tiagojanz/winddragons_rover/hardware/dual_esp_carrier/Dual_ESP_Carrier.png

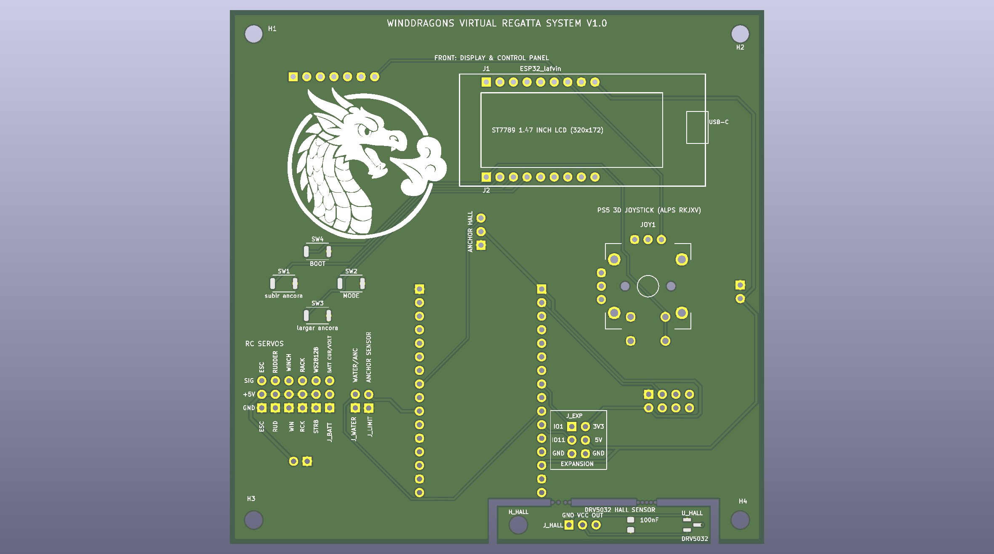
hardware/dual_esp_carrier/Dual_ESP_Carrier.png
