tiagojanz/winddragons_rover/hardware/dual_esp_carrier/Dual_ESP_Carrier_BACK.png

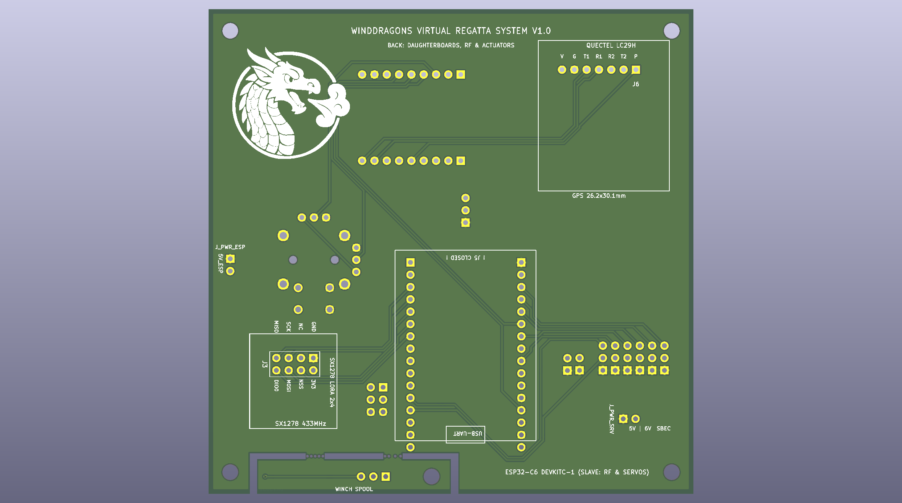
hardware/dual_esp_carrier/Dual_ESP_Carrier_BACK.png
