tiagojanz/winddragons_rover/README.md

# WindDragons - Sistema de Telemetria e Controlo Náutico (Base & Rover)

Projeto de automação e telemetria para boias robóticas náuticas autónomas (**Rovers**) e estação de controlo com ecrã (**Base Station**), baseado na **arquitetura universal Dual ESP32-C6** (Master Lafvin LCD 1.47" + Coprocessador DevKitC-1).

---

## 🛰️ Arquitetura do Sistema (Dual ESP32-C6 em Ambos os Nós)

```
[ WindDragons Portal (Cloud) ]
        ▲
        │ HTTPS REST API (JSON)
        ▼
┌────────────────────────────────────────────────────────┐
│ BASE STATION (Dual ESP32-C6)                           │
│  - Master Lafvin: LCD 1.47" IPS, MicroSD, Web/WiFi,   │
│                   Joystick PS5 e Coordenador OTA Dual │
│         ▲                                              │
│         │ UART Inter-ESP (921600 baud)                │
│         ▼                                              │
│  - Coprocessador C6: Rádio LoRa SX1278 (433MHz)       │
└──────────────────────────┬─────────────────────────────┘
                           │
                           │ LoRa 433 MHz (Ra-02 / SX1278)
                           ▼
┌────────────────────────────────────────────────────────┐
│ ROVER (Boia Náutica - Dual ESP32-C6)                   │
│  - Master Lafvin: LCD 1.47" IPS, MicroSD, Web/WiFi,   │
│                   Joystick local e Coordenador OTA    │
│         ▲                                              │
│         │ UART Inter-ESP (921600 baud)                │
│         ▼                                              │
│  - Coprocessador C6: LoRa 433MHz, GPS LC29H, PWM     │
│    (Motor, Leme, Guincho, Trinco) e Sensores          │
└────────────────────────────────────────────────────────┘
```

---

## 🔌 Esquema de Barramentos e Conexões

O módulo **LoRa Ra-02 (SX1278 a 433MHz)** é ligado exclusivamente ao **Coprocessador ESP32-C6** (evitando conflito com o barramento SPI partilhado entre o LCD e o MicroSD do Lafvin):

### Módulo LoRa SX1278 (433MHz) — Coprocessador ESP32-C6 DevKitC
| Pino Ra-02 | Pino ESP32-C6 | Notas |
| :--- | :--- | :--- |
| **VCC** | `3.3V` | Barramento independente 3.3V_C6 |
| **GND** | `GND` | Terra comum de referência |
| **SCK** | `GPIO 5` | Hardware SPI SCLK |
| **MOSI**| `GPIO 7` | Hardware SPI MOSI |
| **MISO**| `GPIO 4` | Hardware SPI MISO |
| **NSS / CS** | `GPIO 6` | Hardware SPI CS do LoRa |
| **DIO0**| `GPIO 0` | Interrupção de receção de pacotes |

---

### Slot MicroSD (TF Card Onboard) — Em ambas as placas
O slot MicroSD está integrado diretamente na placa ESP32-C6-LCD-1.47 e partilha o barramento SPI com o ecrã ST7789:
| Função SD | Pino ESP32-C6 | Notas |
| :--- | :--- | :--- |
| **CS** | `IO4` | Chip Select do Cartão SD (Ativo LOW) |
| **MOSI** | `IO6` | Partilhado com LCD MOSI |
| **SCLK** | `IO7` | Partilhado com LCD SCLK |
| **MISO** | `IO5` | Linha de leitura MISO |

**Ficheiros suportados na raiz do cartão:**
- `/config.txt` — Ficheiro de configurações lido automaticamente no boot.
- `/waypoints.txt` — Ficheiro de coordenadas de navegação (lido no Rover).
- `/telemetry.csv` — Registo automático de telemetria (GPS, velocidade, rumo, bateria e estado do motor).

---

### Build 1: ROVER (A Boia)
| Componente | Pino do Módulo / Atuador | Pino ESP32-C6 | Função |
| :--- | :--- | :--- | :--- |
| **Motor (ESC)** | Sinal PWM | `IO0` | 50Hz PWM (1000µs a 2000µs, centro 1500µs) |
| **Servo do Leme** | Sinal PWM | `IO1` | 50Hz PWM (Ângulo de direção) |
| **Guincho Âncora** | Sinal PWM | `IO23` | Servo de rotação contínua (1500µs parado, <1500 desce, >1500 sobe) |
| **GPS Quectel LC29H** | TX do GPS | `IO19` | RX UART1 (115200 bps) |
| | RX do GPS | `IO18` | TX UART1 |
| | VCC / GND | `3.3V / GND` | Alimentação |
| **LED RGB Onboard** | Integrado | `IO8` | Estado: Verde (GPS OK), Azul (LoRa), Vermelho (Failsafe) |

---

### Build 2: BASE (Comando Remoto com Ecrã)
| Componente | Pino do Módulo | Pino ESP32-C6 | Função |
| :--- | :--- | :--- | :--- |
| **Joystick (4 vias)** | VCC | `3.3V` | Alimentação do joystick |
| | GND | `GND` | Terra |
| | VRx (Avanço/Recuo) | `IO0` | Entrada Analógica ADC1_CH0 (Aceleração) |
| | VRy (Direção) | `IO1` | Entrada Analógica ADC1_CH1 (Leme) |
| **Botões de Âncora** | Subir Âncora | `IO18` | Entrada Digital (Pull-up interno) |
| | Descer Âncora | `IO19` | Entrada Digital (Pull-up interno) |
| **Botão BOOT** | Onboard | `IO9` | Cicla páginas de ecrã (Comando -> Frota -> Rede) |
| **Ecrã LCD 1.47"** | Integrado ST7789 | `IO14, 15, 21, 22` | Dashboard multi-ecrã Landscape 320x172 (Comando, Frota de Rovers e Rede WiFi) |

---

## 🌐 Conectividade WiFi, Modo AP & Servidor Web

A Base Station inclui gestão inteligente de ligações WiFi e um Servidor Web HTTP responsivo:

### 1. Arranque Inteligente e Fallback para Modo AP:
- **No arranque**: a Base tenta ligar-se à rede marcada como **Padrão (Default)** ou às redes secundárias guardadas na memória NVS (timeout de 8s).
- **Se não houver ligação**: entra automaticamente em **Modo Ponto de Acesso (AP)**:
  - **SSID do AP**: `WindDragons-Base`
  - **Password**: `12345678`
  - **Endereço IP**: `http://192.168.4.1`
- **Ecrã LCD**: ao arrancar (e no menu através de `7. INFO REDE / IP`):
  - Se ligado a WiFi: apresenta o **endereço IP** atribuído (`http://192.168.x.x`), SSID e sinal RSSI.
  - Se em modo AP: apresenta o **SSID da Base**, a password e o endereço `http://192.168.4.1`.

### 2. Páginas do Servidor HTTP:
- **Em Modo AP**:
  - `/wifi`: Interface para procurar redes próximas (Scan WiFi), adicionar redes e marcar a rede de casa/porto como **Default**.
- **Em Modo WiFi (Cliente)**:
  - `/wifi`: Gestão de múltiplas redes guardadas, alteração da rede default, remoção e scanner de sinal.
  - `/gps`: Telemetria e coordenadas GPS do Rover ativo, rumo da proa, velocidade em nós e links diretos para Google Maps e OpenStreetMap.
  - `/battery`: Monitorização da bateria LiPo 4S (tensão do pack, média por célula, percentagem colorida e estado de saúde).
  - `/control`: Comando remoto da boia via rádio LoRa (acelerador do motor ESC com presets, leme, âncora, cremalheira, hold station e botão de paragem de emergência).

---

## 🚀 Como Compilar e Enviar o Firmware

Com o **PlatformIO** instalado:

### 1. Compilar e Enviar para o Rover:
O Rover possui dois módulos ESP32-C6:
- **Rover C6 (Slave):** Controla Rádio LoRa, GPS LC29H, ESC do Motor, Servos e Sensores.
- **Rover Lafvin (Master):** Controla o Ecrã LCD 1.47" ST7789, Leitor MicroSD e Joystick.

```bash
# Rover C6 (Slave - LoRa / GPS / Atuadores)
pio run -e rover_c6 -t upload
pio device monitor -e rover_c6

# Rover Lafvin (Master - LCD / MicroSD)
pio run -e rover_lafvin -t upload
pio device monitor -e rover_lafvin

# Ou gerar pacote unificado para atualização remota (OTA):
python3 scripts/bundle_firmware.py
```

### 2. Compilar e Enviar para a Base:
```bash
# Compilar e Enviar Base
pio run -e base -t upload

# Monitor Série (115200 baud)
pio device monitor -e base
```

---

## 📡 Integração com a API WindDragons

A cada 3 segundos, a Base agrupa os rovers ativos e envia um pedido `POST` para `https://winddragons.app/api/circuits/station/telemetry`:

```json
{
  "station_id": "BASE-ALCOCHETE-01",
  "rovers": [
    {
      "rover_code": "ROVER-01",
      "lat": 38.750508,
      "lng": -8.973995,
      "speed": 0.2,
      "heading": 185.0,
      "battery_pct": 92,
      "battery_voltage": 12.5,
      "motor_status": "holding_station",
      "anchor_status": "retracted",
      "anchor_depth_m": 0.0,
      "rssi": -65
    }
  ]
}
```

Caso o servidor responda com comandos pendentes (ex: `DROP_ANCHOR`, `RETRACT_ANCHOR`, `HOLD_STATION`), a Base coloca o comando na fila e transmite-o imediatamente via rádio LoRa para o rover visado!
