tiagojanz/winddragons_rover/hardware/dual_esp_carrier/drc_report.txt

** Drc report for Dual_ESP_Carrier.kicad_pcb **
** Created on 2026-10-16T17:02:59 **
** Report includes: Errors, Warnings **

** Found 38 DRC violations **
[lib_footprint_mismatch]: O footprint 'MountingHole_3.2mm_M3' não corresponde à cópia na biblioteca 'MountingHole'
    Local override; warning
    @(4.5000 mm, 95.5000 mm): Footprint H3
[lib_footprint_mismatch]: O footprint 'MountingHole_3.2mm_M3' não corresponde à cópia na biblioteca 'MountingHole'
    Local override; warning
    @(95.5000 mm, 95.5000 mm): Footprint H4
[lib_footprint_mismatch]: O footprint 'PinHeader_1x03_P2.54mm_Vertical' não corresponde à cópia na biblioteca 'Connector_PinHeader_2.54mm'
    Local override; warning
    @(10.0000 mm, 73.5800 mm): Footprint ESC
[lib_footprint_mismatch]: O footprint 'MountingHole_3.2mm_M3' não corresponde à cópia na biblioteca 'MountingHole'
    Local override; warning
    @(4.5000 mm, 4.5000 mm): Footprint H1
[lib_footprint_mismatch]: O footprint 'PinHeader_1x09_P2.54mm_Horizontal' não corresponde à cópia na biblioteca 'Connector_PinHeader_2.54mm'
    Local override; warning
    @(48.0000 mm, 31.2800 mm): Footprint J2
[lib_footprint_mismatch]: O footprint 'MountingHole_3.2mm_M3' não corresponde à cópia na biblioteca 'MountingHole'
    Local override; warning
    @(95.5000 mm, 4.5000 mm): Footprint H2
[lib_footprint_issues]: A configuração atual não inclui a biblioteca de footprints 'PS4_joystick'
    Local override; warning
    @(22.7300 mm, 51.2200 mm): Footprint SW2
[lib_footprint_issues]: A configuração atual não inclui a biblioteca de footprints 'PS4_joystick'
    Local override; warning
    @(16.4300 mm, 45.2200 mm): Footprint SW4
[lib_footprint_issues]: A configuração atual não inclui a biblioteca de footprints 'PS5_joystick'
    Local override; warning
    @(78.2525 mm, 51.7150 mm): Footprint JOY1
[lib_footprint_mismatch]: O footprint 'PinHeader_1x02_P2.54mm_Vertical' não corresponde à cópia na biblioteca 'Connector_PinHeader_2.54mm'
    Local override; warning
    @(4.0000 mm, 73.5800 mm): Footprint J_LIMIT
[lib_footprint_mismatch]: O footprint 'PinHeader_1x03_P2.54mm_Vertical' não corresponde à cópia na biblioteca 'Connector_PinHeader_2.54mm'
    Local override; warning
    @(13.0000 mm, 73.5800 mm): Footprint RUD
[lib_footprint_issues]: A configuração atual não inclui a biblioteca de footprints 'PS4_joystick'
    Local override; warning
    @(16.4300 mm, 57.2200 mm): Footprint SW3
[lib_footprint_mismatch]: O footprint 'PinHeader_1x03_P2.54mm_Vertical' não corresponde à cópia na biblioteca 'Connector_PinHeader_2.54mm'
    Local override; warning
    @(19.0000 mm, 73.5000 mm): Footprint RCK
[lib_footprint_mismatch]: O footprint 'PinHeader_1x09_P2.54mm_Horizontal' não corresponde à cópia na biblioteca 'Connector_PinHeader_2.54mm'
    Local override; warning
    @(48.0000 mm, 13.5000 mm): Footprint J1
[lib_footprint_issues]: A configuração atual não inclui a biblioteca de footprints 'PS4_joystick'
    Local override; warning
    @(10.1300 mm, 51.2200 mm): Footprint SW1
[lib_footprint_mismatch]: O footprint 'PinHeader_1x03_P2.54mm_Vertical' não corresponde à cópia na biblioteca 'Connector_PinHeader_2.54mm'
    Local override; warning
    @(7.0000 mm, 73.5800 mm): Footprint STRB
[lib_footprint_mismatch]: O footprint 'PinHeader_1x03_P2.54mm_Vertical' não corresponde à cópia na biblioteca 'Connector_PinHeader_2.54mm'
    Local override; warning
    @(16.0000 mm, 73.5000 mm): Footprint WIN
[lib_footprint_mismatch]: O footprint 'PinHeader_2x04_P2.54mm_Vertical' não corresponde à cópia na biblioteca 'Connector_PinHeader_2.54mm'
    Local override; warning
    @(77.5400 mm, 72.0000 mm): Footprint J3
[lib_footprint_mismatch]: O footprint 'PinHeader_1x02_P2.54mm_Vertical' não corresponde à cópia na biblioteca 'Connector_PinHeader_2.54mm'
    Local override; warning
    @(25.0000 mm, 73.5000 mm): Footprint J_WATER
[lib_footprint_mismatch]: O footprint 'PinHeader_1x16_P2.54mm_Vertical' não corresponde à cópia na biblioteca 'Connector_PinHeader_2.54mm'
    Local override; warning
    @(58.3600 mm, 52.2500 mm): Footprint J_DK_L
[lib_footprint_mismatch]: O footprint 'PinHeader_1x02_P2.54mm_Vertical' não corresponde à cópia na biblioteca 'Connector_PinHeader_2.54mm'
    Local override; warning
    @(95.5000 mm, 51.5000 mm): Footprint J_PWR_ESP
[lib_footprint_mismatch]: O footprint 'PinHeader_1x02_P2.54mm_Vertical' não corresponde à cópia na biblioteca 'Connector_PinHeader_2.54mm'
    Local override; warning
    @(5.0000 mm, 77.7300 mm): Footprint J_PWR_SRV
[lib_footprint_mismatch]: O footprint 'PinHeader_1x07_P2.54mm_Horizontal' não corresponde à cópia na biblioteca 'Connector_PinHeader_2.54mm'
    Local override; warning
    @(11.8800 mm, 12.5000 mm): Footprint J6
[lib_footprint_mismatch]: O footprint 'PinHeader_1x03_P2.54mm_Vertical' não corresponde à cópia na biblioteca 'Connector_PinHeader_2.54mm'
    Local override; warning
    @(22.0000 mm, 73.5000 mm): Footprint J_BATT
[lib_footprint_mismatch]: O footprint 'PinHeader_1x16_P2.54mm_Vertical' não corresponde à cópia na biblioteca 'Connector_PinHeader_2.54mm'
    Local override; warning
    @(35.5000 mm, 52.2500 mm): Footprint J_DK_R
[silk_overlap]: Silkscreen clearance
    Rule: configuração da serigrafia da placa; warning
    @(7.0000 mm, 71.0400 mm): Ilha PTH 2 [/+5V_SERVO] de STRB
    @(7.6000 mm, 71.0400 mm): Texto da PCI '+5V' em F.Silkscreen
[silk_overlap]: Silkscreen clearance
    Rule: configuração da serigrafia da placa; warning
    @(7.6000 mm, 73.5800 mm): Texto da PCI 'GND' em F.Silkscreen
    @(7.0000 mm, 73.5800 mm): Ilha PTH 1 [/GND] de STRB
[silk_overlap]: Silkscreen clearance
    Rule: configuração da serigrafia da placa; warning
    @(7.6000 mm, 68.5000 mm): Texto da PCI 'SIG' em F.Silkscreen
    @(7.0000 mm, 68.5000 mm): Ilha PTH 3 [/STROBE_DIN] de STRB
[silk_overlap]: Silkscreen clearance
    Rule: configuração da serigrafia da placa; warning
    @(7.0000 mm, 68.5000 mm): Ilha PTH 3 [/STROBE_DIN] de STRB
    @(7.0000 mm, 66.0000 mm): Valor do campo de STRB (WS2812B)
[silk_overlap]: Silkscreen clearance
    Rule: configuração da serigrafia da placa; warning
    @(11.8800 mm, 9.8000 mm): Texto do footprint de J6 (P)
    @(3.5000 mm, 10.0000 mm): Retângulo no B.Silkscreen
[silk_overlap]: Silkscreen clearance
    Rule: configuração da serigrafia da placa; warning
    @(22.0400 mm, 9.8000 mm): Texto do footprint de J6 (T1)
    @(3.5000 mm, 10.0000 mm): Retângulo no B.Silkscreen
[silk_overlap]: Silkscreen clearance
    Rule: configuração da serigrafia da placa; warning
    @(3.5000 mm, 10.0000 mm): Retângulo no B.Silkscreen
    @(27.1200 mm, 9.8000 mm): Texto do footprint de J6 (V)
[silk_overlap]: Silkscreen clearance
    Rule: configuração da serigrafia da placa; warning
    @(24.5800 mm, 9.8000 mm): Texto do footprint de J6 (G)
    @(3.5000 mm, 10.0000 mm): Retângulo no B.Silkscreen
[silk_overlap]: Silkscreen clearance
    Rule: configuração da serigrafia da placa; warning
    @(19.5000 mm, 9.8000 mm): Texto do footprint de J6 (R1)
    @(3.5000 mm, 10.0000 mm): Retângulo no B.Silkscreen
[silk_overlap]: Silkscreen clearance
    Rule: configuração da serigrafia da placa; warning
    @(14.4200 mm, 9.8000 mm): Texto do footprint de J6 (T2)
    @(3.5000 mm, 10.0000 mm): Retângulo no B.Silkscreen
[silk_overlap]: Silkscreen clearance
    Rule: configuração da serigrafia da placa; warning
    @(16.9600 mm, 9.8000 mm): Texto do footprint de J6 (R2)
    @(3.5000 mm, 10.0000 mm): Retângulo no B.Silkscreen
[silk_overlap]: Silkscreen clearance
    Rule: configuração da serigrafia da placa; warning
    @(5.0000 mm, 80.2700 mm): Ilha PTH 2 [/+5V_SERVO] de J_PWR_SRV
    @(5.0000 mm, 82.7300 mm): Valor do campo de J_PWR_SRV (5V_SERVO)
[silk_overlap]: Silkscreen clearance
    Rule: configuração da serigrafia da placa; warning
    @(22.0000 mm, 66.0000 mm): Valor do campo de J_BATT (BATT V/I/G)
    @(22.0000 mm, 68.4200 mm): Ilha PTH 3 [/BATT_VOLT] de J_BATT

** Found 0 unconnected pads **

** Found 0 Footprint errors **

** Ignored checks **
    - Footprint has no courtyard defined
    - Track endpoint not centered on via
    - Tuning profile track geometries
    - Footprint doesn't match symbol's footprint filters
    - Footprint component type doesn't match footprint pads

** End of Report **
