tiagojanz/winddragons_rover/hardware/base_pcb/Base_Carrier_pcb_top.png

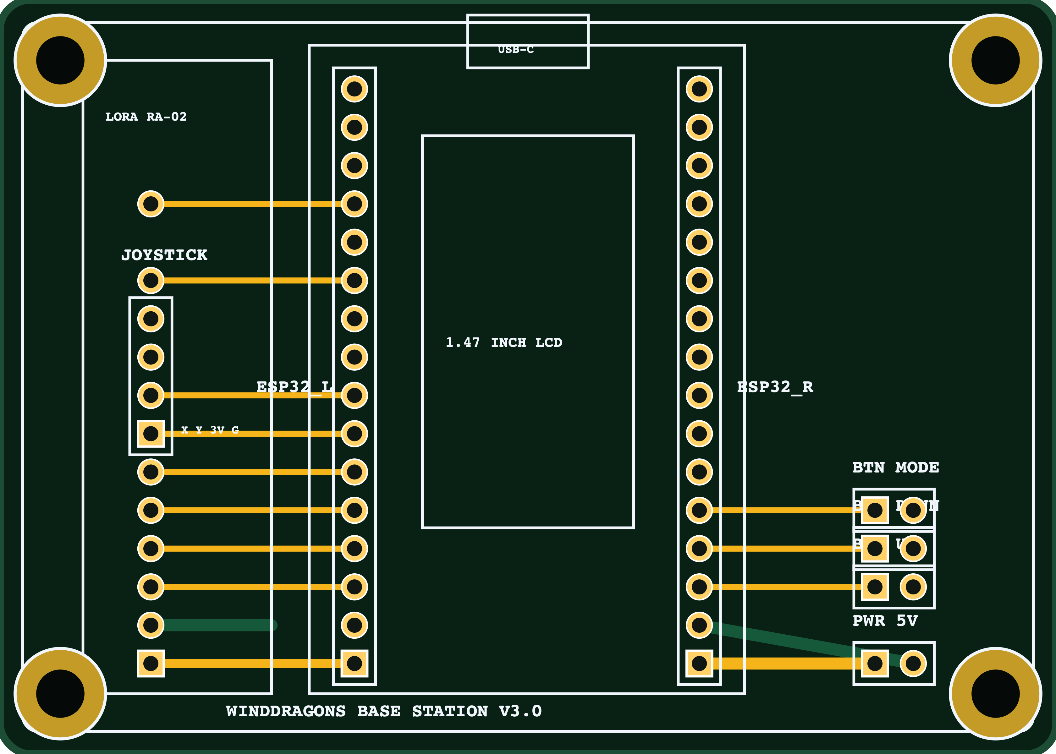
hardware/base_pcb/Base_Carrier_pcb_top.png
