tiagojanz/winddragons_rover/hardware/dual_esp_carrier/Dual_ESP_Carrier_3d_top.png

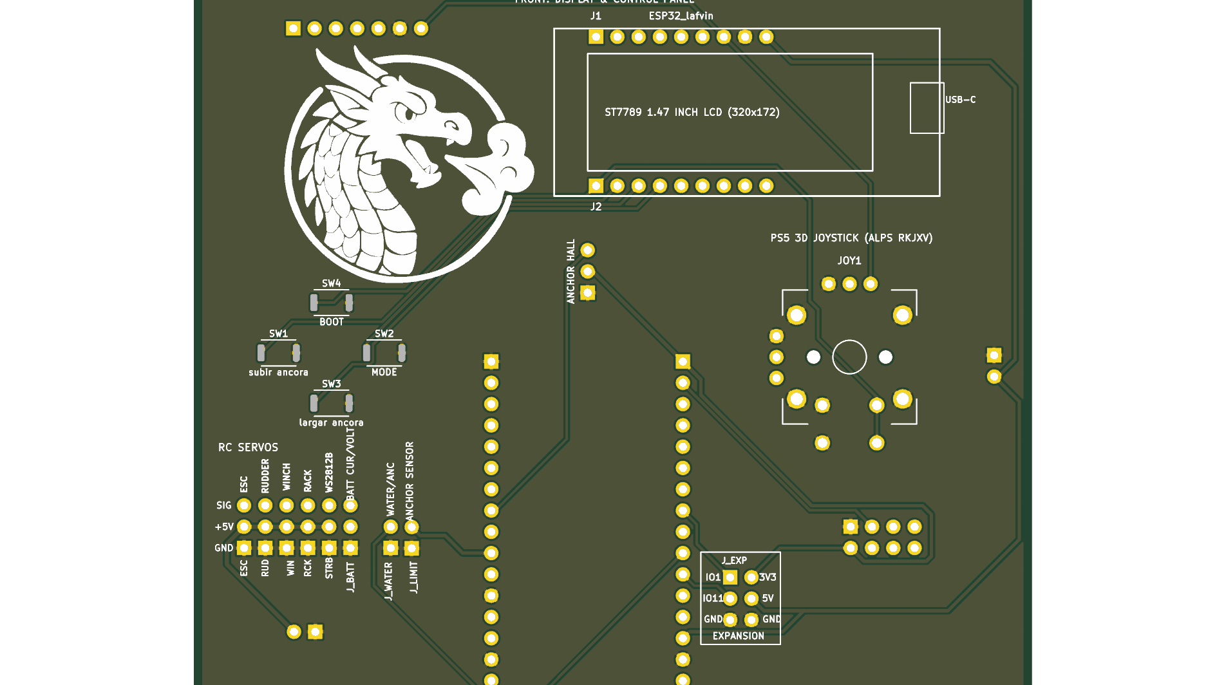
hardware/dual_esp_carrier/Dual_ESP_Carrier_3d_top.png
