tiagojanz/winddragons_rover/hardware/rover_pcb/Rover_Carrier_pcb_top.png

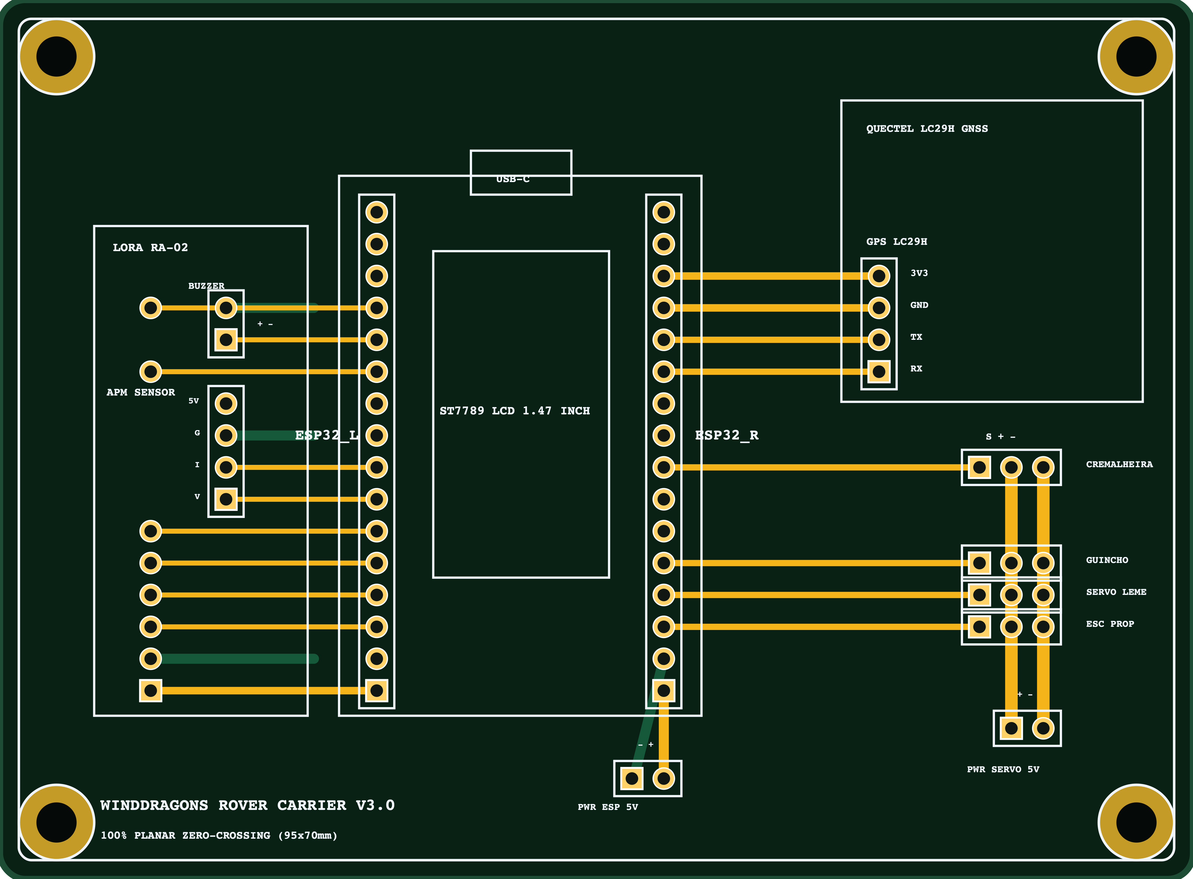
hardware/rover_pcb/Rover_Carrier_pcb_top.png
