tiagojanz/winddragons_rover/hardware/universal_pcb - simple/Universal_Carrier_3d_bottom_angle.png

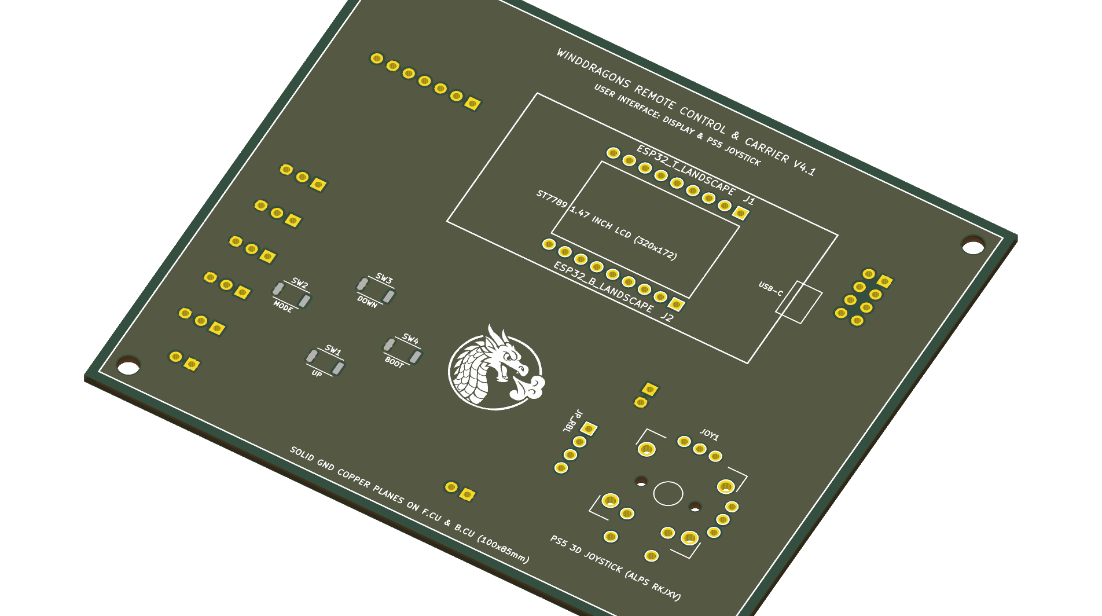
hardware/universal_pcb - simple/Universal_Carrier_3d_bottom_angle.png
