tiagojanz/winddragons_rover/hardware/universal_pcb - simple/Universal_Carrier_schematic.png

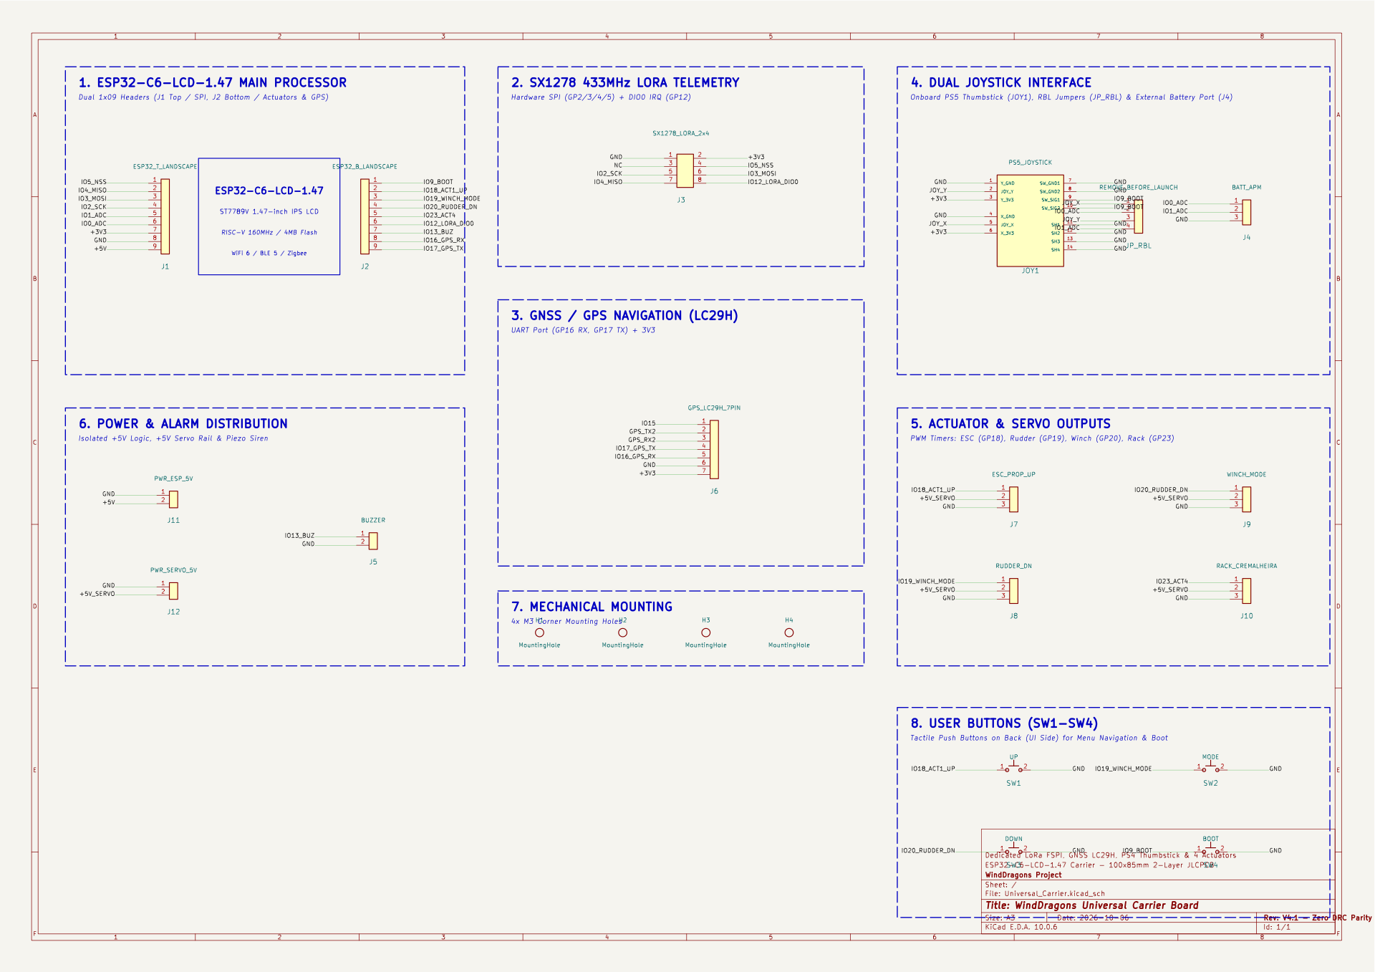
hardware/universal_pcb - simple/Universal_Carrier_schematic.png
