tiagojanz/winddragons_rover/hardware/universal_pcb/head_original.png

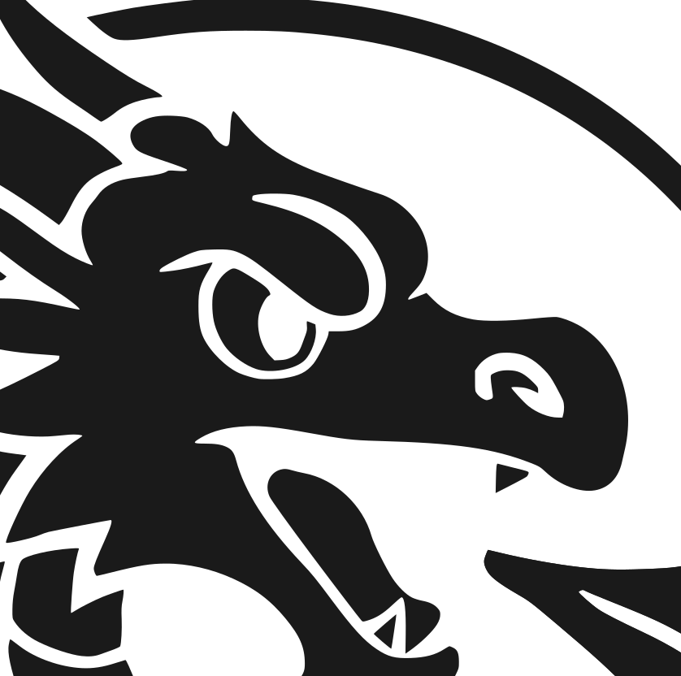
hardware/universal_pcb/head_original.png
