tiagojanz/winddragons_rover/hardware/universal_pcb/Universal_Carrier_3d.png

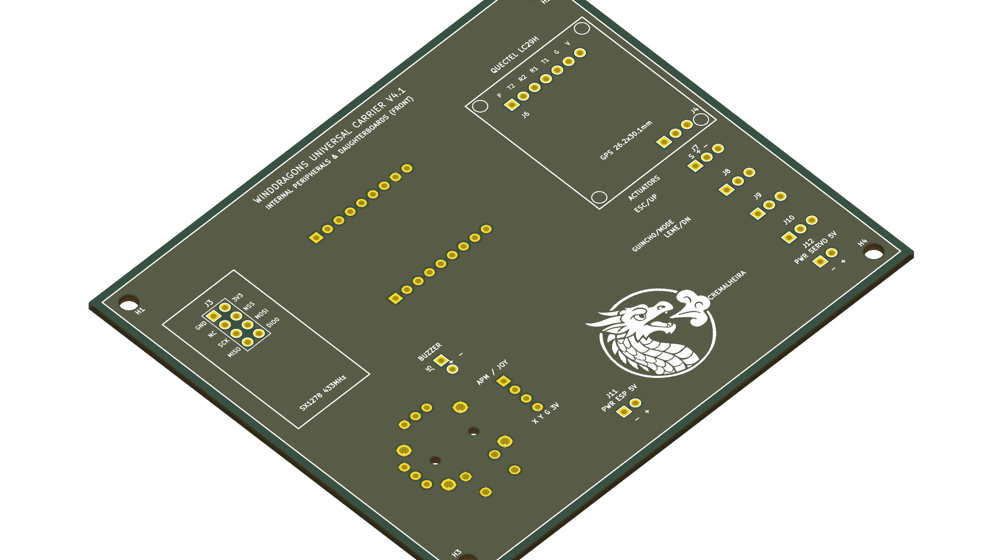
hardware/universal_pcb/Universal_Carrier_3d.png
