tiagojanz/winddragons_rover/hardware/dual_esp_carrier/Dual_ESP_Carrier.step

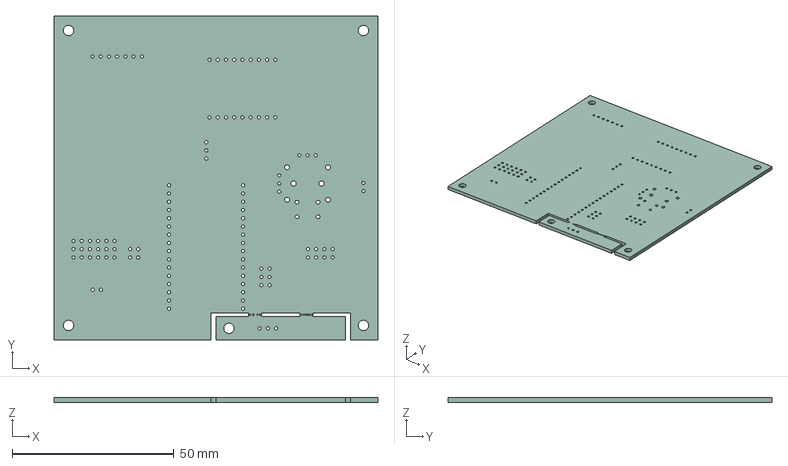
[picture p13: CAD file, 2026-10-29]
hardware/dual_esp_carrier/Dual_ESP_Carrier.step
100.0 x 100.0 x 1.51 mm
