tiagojanz/winddragons_rover/hardware/universal_pcb - simple/Universal_Carrier.step

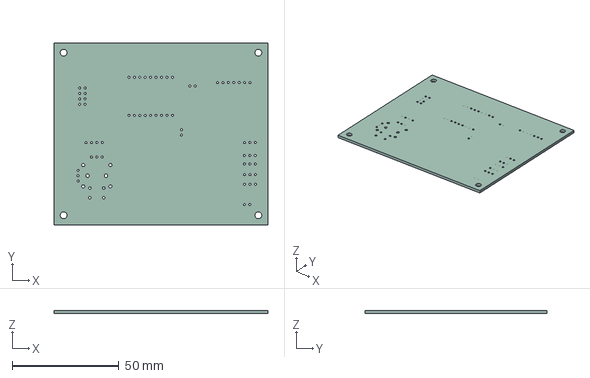
[picture p14: CAD file, 2026-10-09]
hardware/universal_pcb - simple/Universal_Carrier.step
100.0 x 85.0 x 1.51 mm
