tiagojanz/winddragons_rover/hardware/universal_pcb - simple/ESP32-C6-LCD-1.47.stp

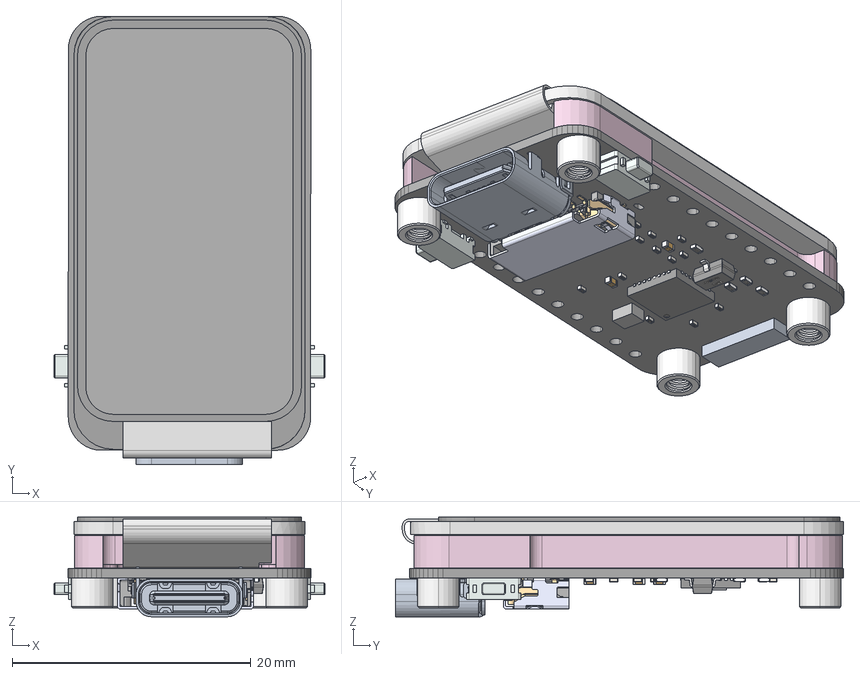
[picture p15: CAD file, 2026-10-09]
hardware/universal_pcb - simple/ESP32-C6-LCD-1.47.stp
22.7 x 37.6 x 8.35 mm
1_47INCH-172X320-LCD
ESP32-S3-LCD-1_47-PMMA
BOARD
USER_LIBRARY-RES_0603-0201_1 x 19
USER_LIBRARY-RES_0603-0201_2 x 19
USER_LIBRARY-RES_0603-0201_3 x 19
USER_LIBRARY-RES_0603-0201_4 x 19
2_A x 13
3_1_A x 3
SOT-23
5_1_2_A x 4
_7_AF0 x 4
USER_LIBRARY-ESP8266EX
EXTRUDED-335204
EXTRUDED-335599
SMTSO-M2-2_5ET x 4
SWITCH-TS24CA x 2
TF-CARD-BASE
C3
