tiagojanz/winddragons_rover/(list of files, cad)

Other CAD files:
hardware/universal_pcb - simple/ESP32-C6-LCD-1.47.dxf
