tiagojanz/winddragons_rover/hardware/universal_pcb/Universal_Carrier_schematic.pdf

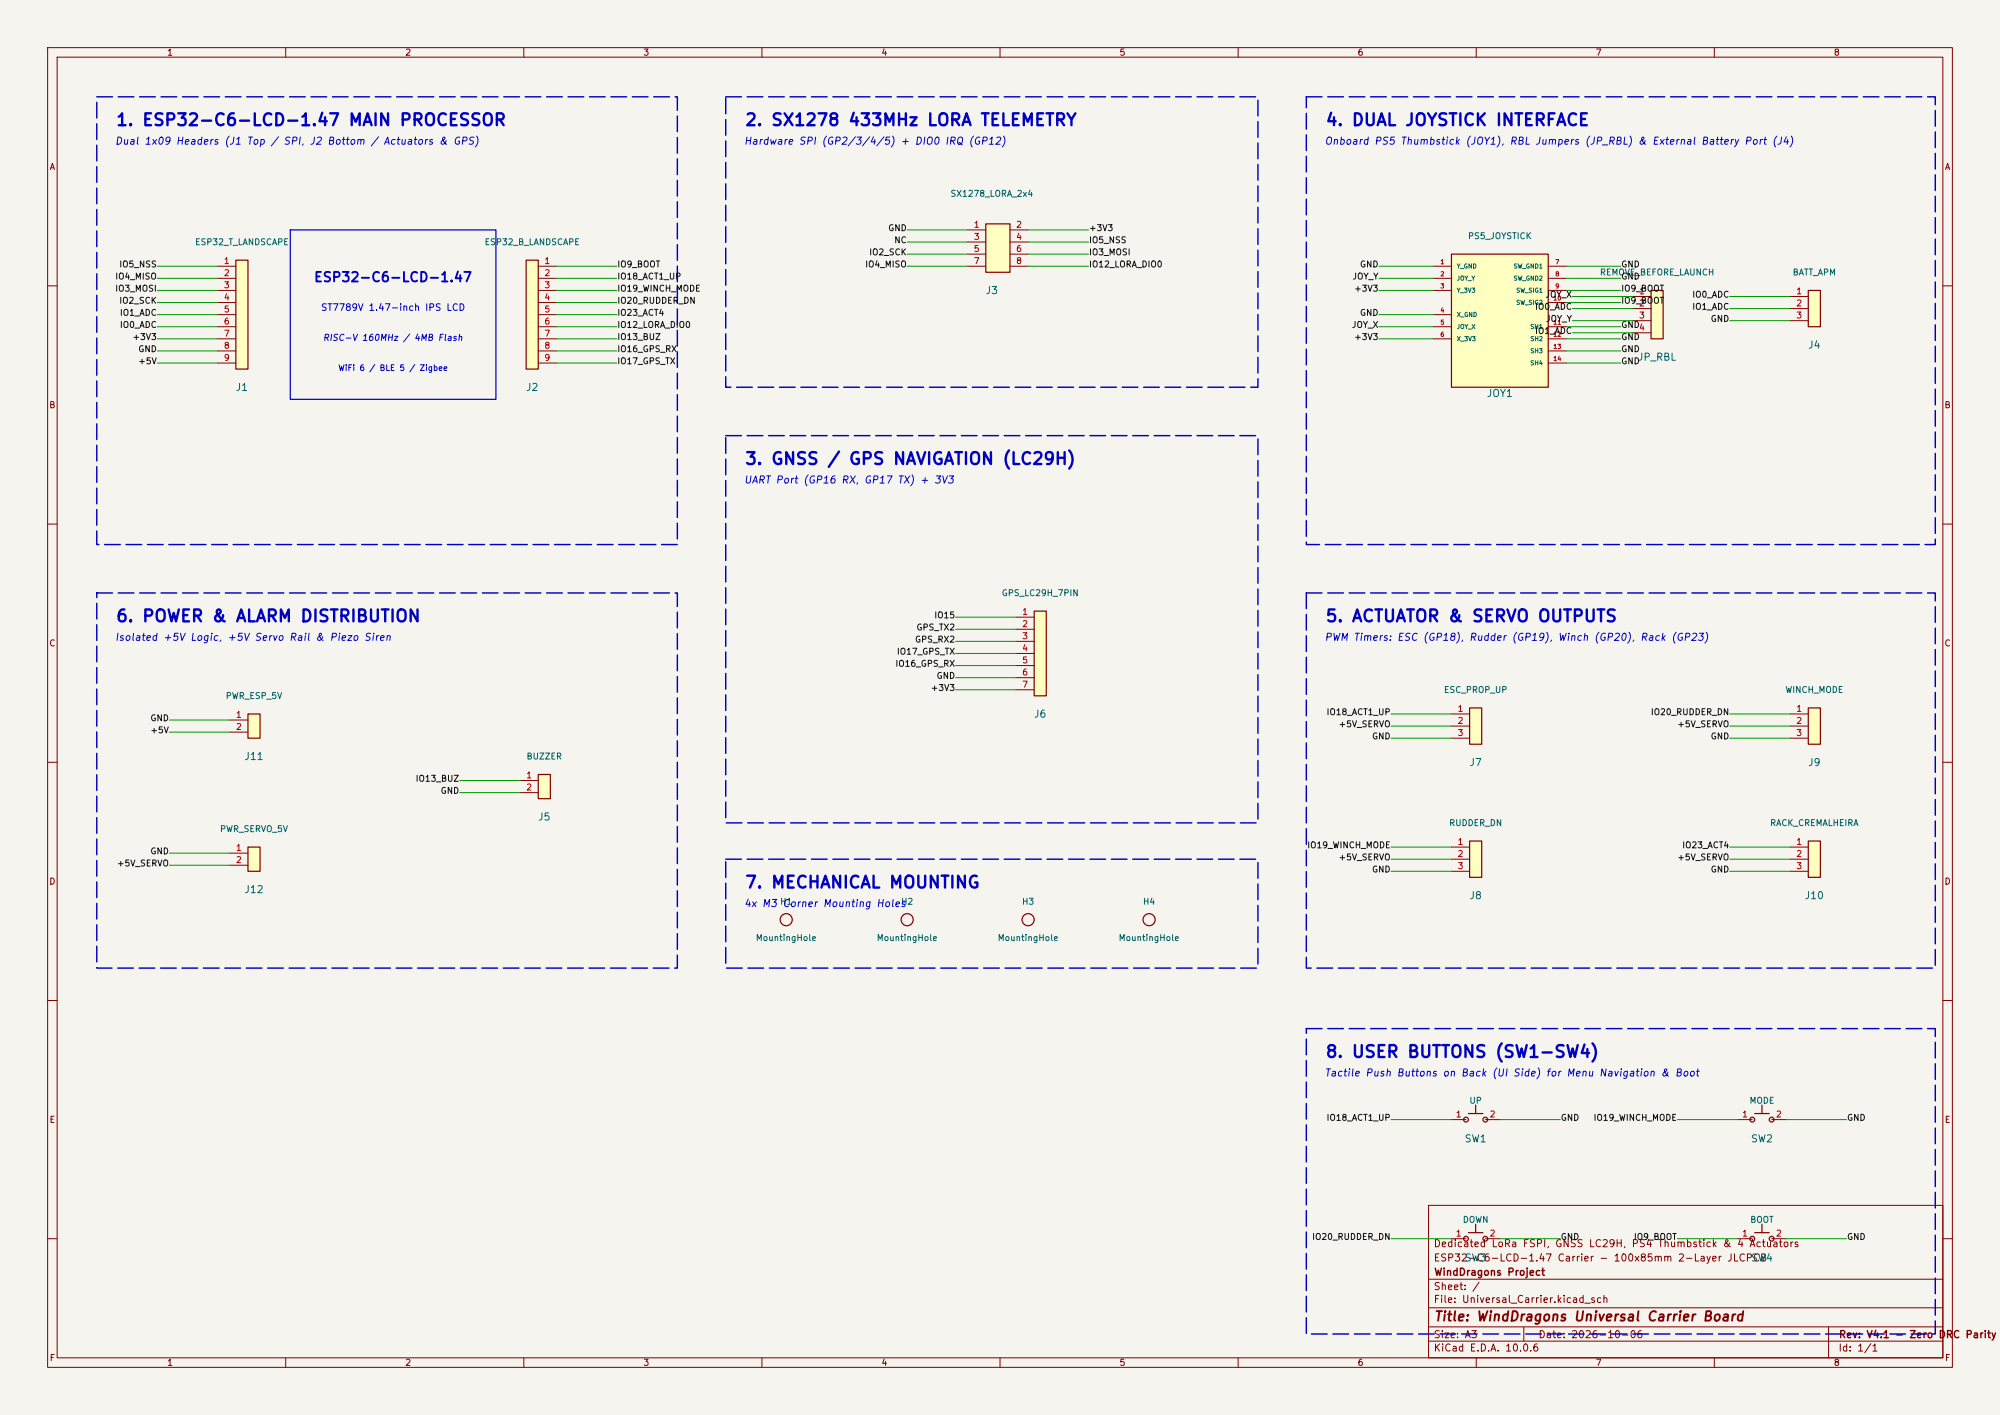
[picture p16: page 1]

Dual 1x09 Headers (J1 Top / SPI, J2 Bottom / Actuators & GPS)

UART Port (GP16 RX, GP17 TX) + 3V3

Isolated +5V Logic, +5V Servo Rail & Piezo Siren

PWM Timers: ESC (GP18), Rudder (GP19), Winch (GP20), Rack (GP23)

Tactile Push Buttons on Back (UI Side) for Menu Navigation & Boot

DOWN
Dedicated LoRa FSPI, GNSS LC29H, PS4 Thumbstick & 4 Actuators
ESP32-C6-LCD-1.47 Carrier - 100x85mm 2-Layer JLCPCB
WindDragons Project

Sheet: / File: Universal_Carrier.kicad_sch

Title: WindDragons Universal Carrier Board
