tiagojanz/winddragons_rover/hardware/dual_esp_carrier/Dual_ESP_Carrier.kicad_pcb

## KiCad design hardware/dual_esp_carrier/Dual_ESP_Carrier.kicad_pcb (2026-10-19)

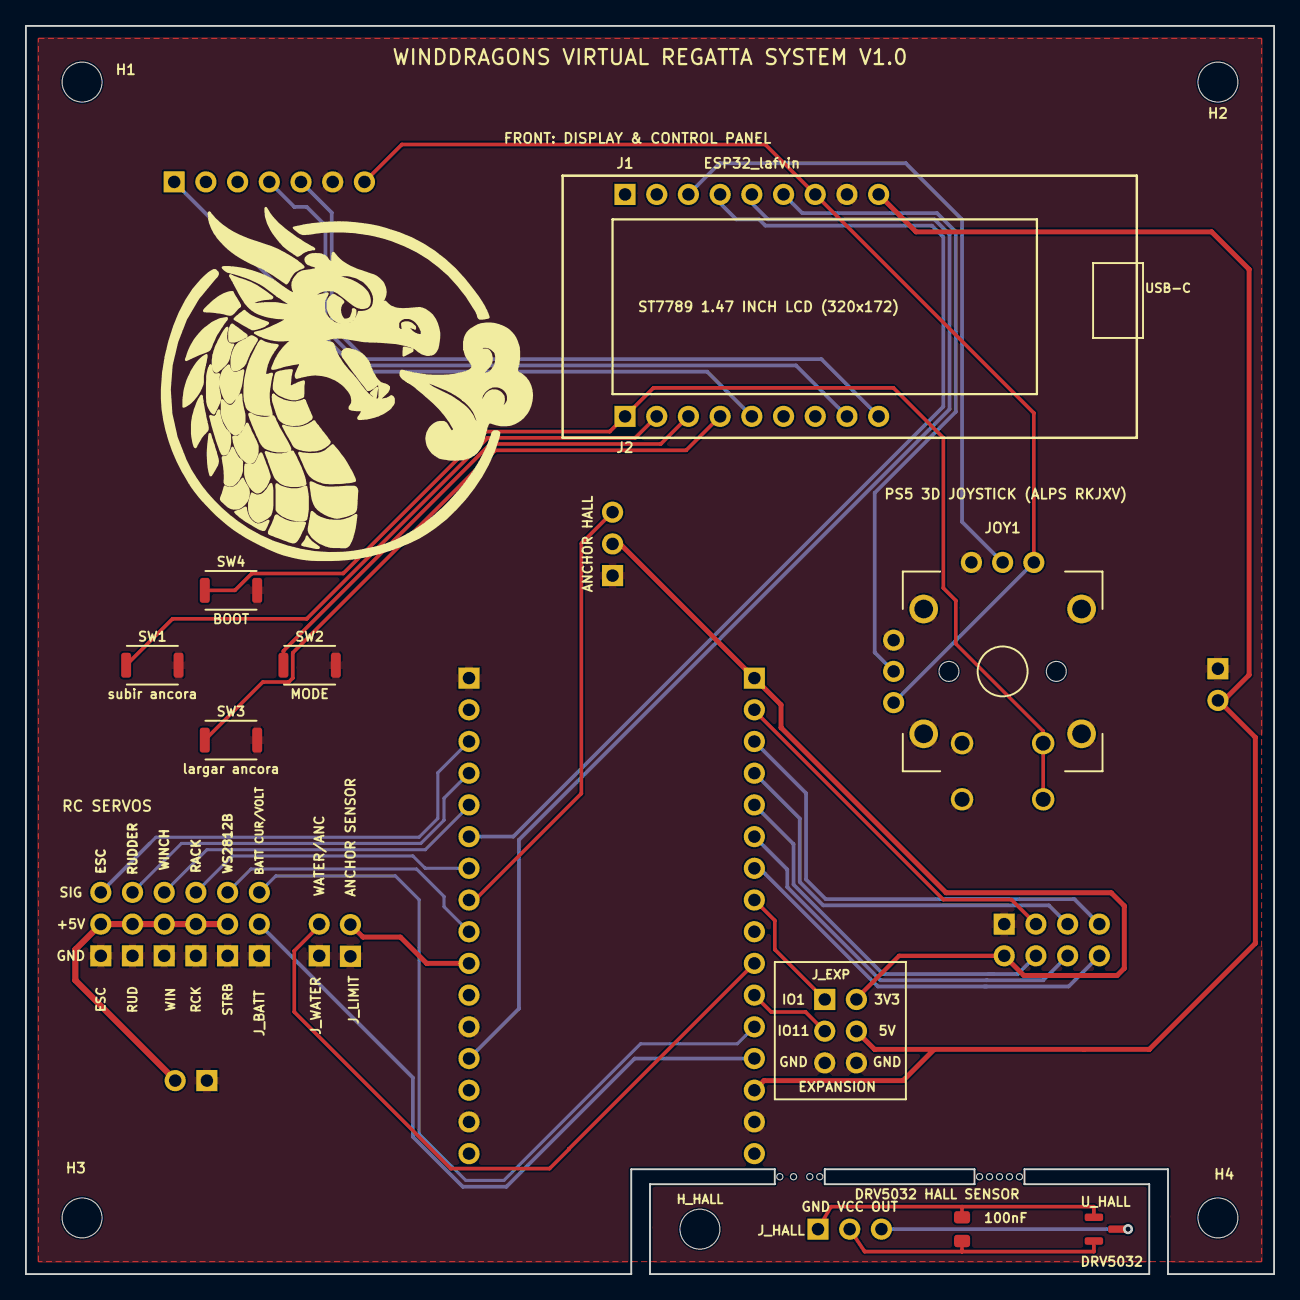
[picture p17: board Dual_ESP_Carrier.kicad_pcb from above]

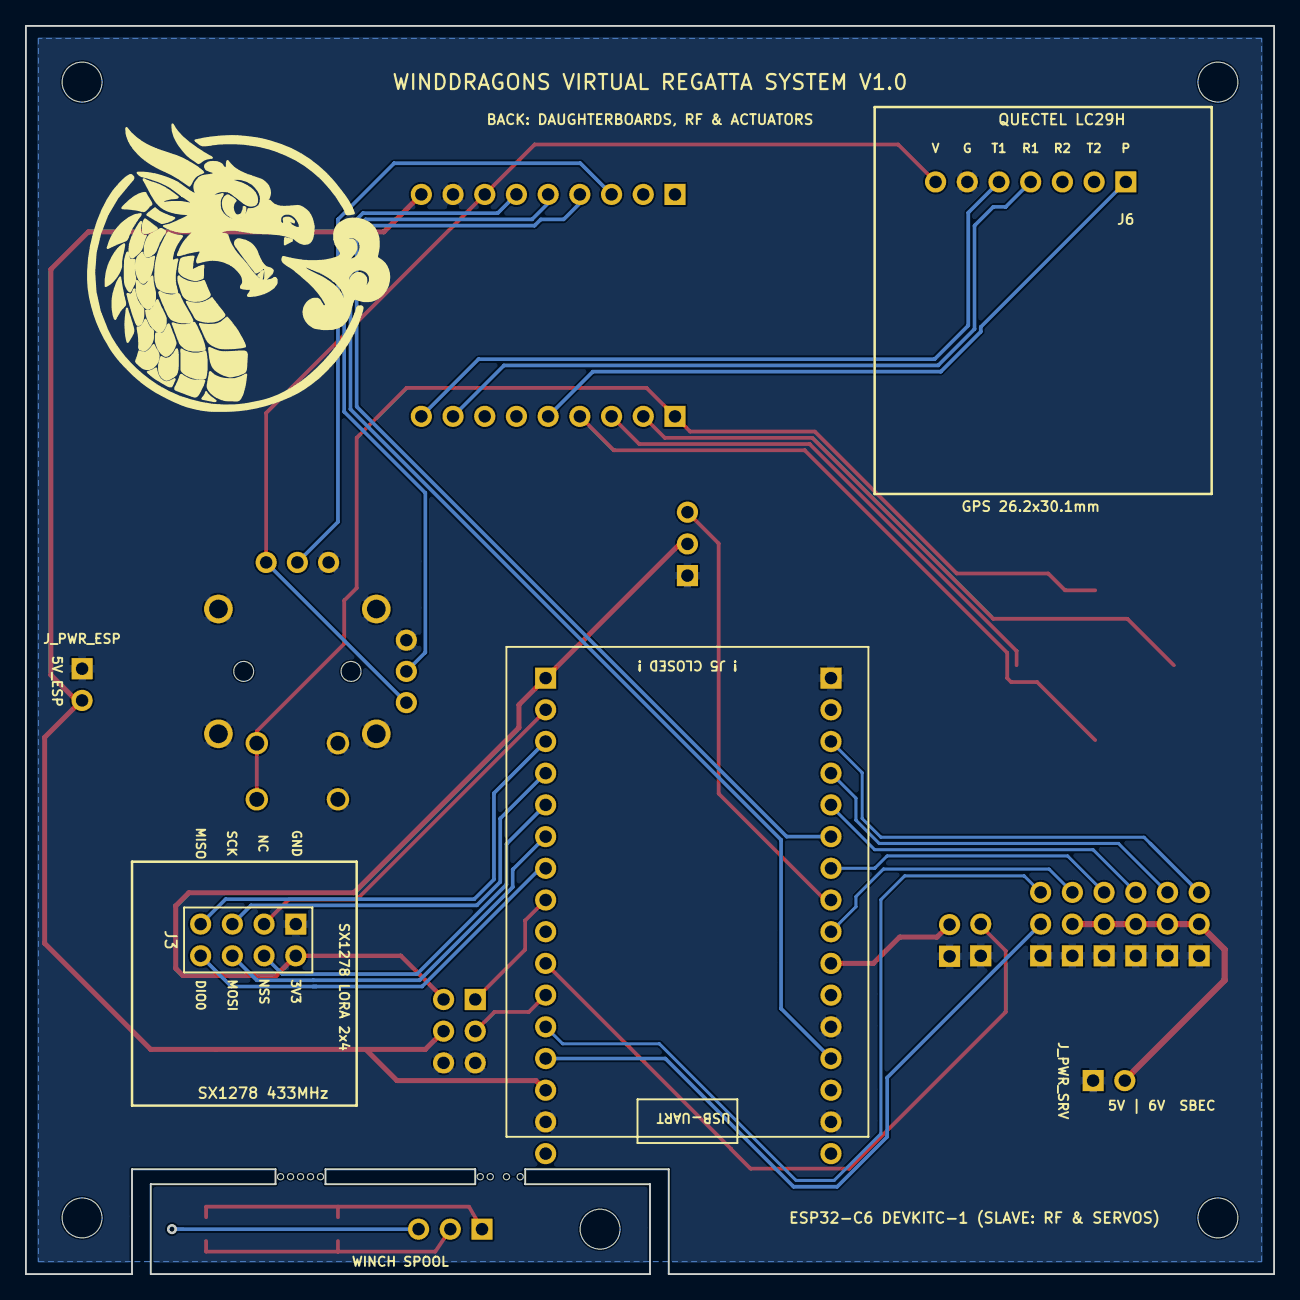
[picture p18: board Dual_ESP_Carrier.kicad_pcb from below]

Board: 2 copper layers, 100.0 x 100.0 mm, 40 parts (6 on the bottom side), 37 nets.

Parts:
C_HALL: 100nF; C_0805_2012Metric
ESC: ESC; PinHeader_1x03_P2.54mm_Vertical
H1, H2, H3, H4: MountingHole_3.2mm_M3
HALL: ANCHOR HALL; PinHeader_1x03_P2.54mm_Vertical
H_HALL: M3_MOUNT; MountingHole_3.2mm_M3
J1: ESP32_lafvin; PinHeader_1x09_P2.54mm_Horizontal
J2: ESP32_B_LANDSCAPE; PinHeader_1x09_P2.54mm_Horizontal
J3: SX1278_LORA_2x4; PinHeader_2x04_P2.54mm_Vertical
J6: GPS_LC29H_7PIN; PinHeader_1x07_P2.54mm_Horizontal
JOY1: PS5_JOYSTICK; Alps_RKJXV1224005
J_BATT: BATT CUR/VOLT; PinHeader_1x03_P2.54mm_Vertical
J_DK_L: PinHeader_1x16_P2.54mm_Vertical
J_DK_R: PinHeader_1x16_P2.54mm_Vertical
J_EXP: EXPANSION; PinHeader_2x03_P2.54mm_Vertical
J_HALL: GND_VCC_OUT; PinHeader_1x03_P2.54mm_Horizontal
J_LIMIT: ANCHOR SENSOR; PinHeader_1x02_P2.54mm_Vertical
J_PWR_ESP: 5V_ESP; PinHeader_1x02_P2.54mm_Vertical
J_PWR_SRV: 5V | 6V SBEC; PinHeader_1x02_P2.54mm_Vertical
J_WATER: WATER/ANC; PinHeader_1x02_P2.54mm_Vertical
RCK: RACK; PinHeader_1x03_P2.54mm_Vertical
RUD: RUDDER; PinHeader_1x03_P2.54mm_Vertical
STAMP: MountingHole_0.5mm
STAMP#2, STAMP#3, STAMP#4, STAMP#5, STAMP#6, STAMP#7, STAMP#8, STAMP#9: MountingHole_0.5mm
STRB: WS2812B; PinHeader_1x03_P2.54mm_Vertical
SW1: subir ancora; SKRKAEE020
SW2: MODE; SKRKAEE020
SW3: largar ancora; SKRKAEE020
SW4: BOOT; SKRKAEE020
U_HALL: DRV5032; SOT-23
WIN: WINCH; PinHeader_1x03_P2.54mm_Vertical

Connections:
/+3V3: J1.7, J6.7, JOY1.3, JOY1.6
/+3V3_C6: HALL.2, J3.2, J_DK_L.1, J_EXP.2
/+5V: J1.9, J_DK_L.14, J_EXP.4, J_PWR_ESP.2
/+5V_SERVO: ESC.2, J_PWR_SRV.2, RCK.2, RUD.2, STRB.2, WIN.2
/ANCHOR_HALL: HALL.3, J_DK_R.8
/ANCHOR_LIMIT: J_DK_R.10, J_LIMIT.2
/BATT_CURR: J_BATT.2, J_DK_L.13
/BATT_VOLT: J_BATT.3, J_DK_L.12
/EXP_IO1: J_DK_L.8, J_EXP.1
/EXP_IO11: J_DK_L.11, J_EXP.3
/GND: ESC.1, HALL.1, J1.8, J3.1, J6.6, JOY1.1, JOY1.4, JOY1.7, JOY1.8, JOY1.11, JOY1.12, JOY1.13, JOY1.14, J_BATT.1, J_DK_L.15, J_DK_R.1, J_DK_R.12, J_DK_R.15, J_EXP.5, J_EXP.6, J_LIMIT.1, J_PWR_ESP.1, J_PWR_SRV.1, J_WATER.1, RCK.1, RUD.1, STRB.1, SW1.2, SW2.2, SW3.2, SW4.2, WIN.1
/GPS_PPS: J2.5, J6.1
/GPS_RX: J2.8, J6.4
/GPS_TX: J2.9, J6.5
/HALL_GND: C_HALL.2, J_HALL.1, U_HALL.1
/HALL_OUT: J_HALL.3, U_HALL.3
/HALL_VCC: C_HALL.1, J_HALL.2, U_HALL.2
/INTER_RX_S2M: J1.5, J_DK_R.13
/INTER_TX_M2S: J1.4, J_DK_R.6
/IO9_BOOT: J2.1, JOY1.9, JOY1.10, SW4.1
/IO18_UP: J2.2, SW1.1
/IO19_MODE: J2.3, SW2.1
/IO20_DN: J2.4, SW3.1
/JOY_X: J1.3, JOY1.5
/JOY_Y: J1.6, JOY1.2
/LORA_DIO0: J3.8, J_DK_L.7
/LORA_MISO: J3.7, J_DK_L.3
/LORA_MOSI: J3.6, J_DK_L.6
/LORA_NSS: J3.4, J_DK_L.5
/LORA_RST: J3.3, J_DK_L.2
/LORA_SCK: J3.5, J_DK_L.4
/SERVO_ESC: ESC.3, J_DK_R.3
/SERVO_RACK: J_DK_R.7, RCK.3
/SERVO_RUDDER: J_DK_R.4, RUD.3
/SERVO_WINCH: J_DK_R.5, WIN.3
/STROBE_DIN: J_DK_R.9, STRB.3
/WATER_SENS: J_DK_L.10, J_WATER.2
