tiagojanz/winddragons_rover/hardware/universal_pcb/Universal_Carrier.kicad_pcb

## KiCad design hardware/universal_pcb/Universal_Carrier.kicad_pcb (2026-10-14)

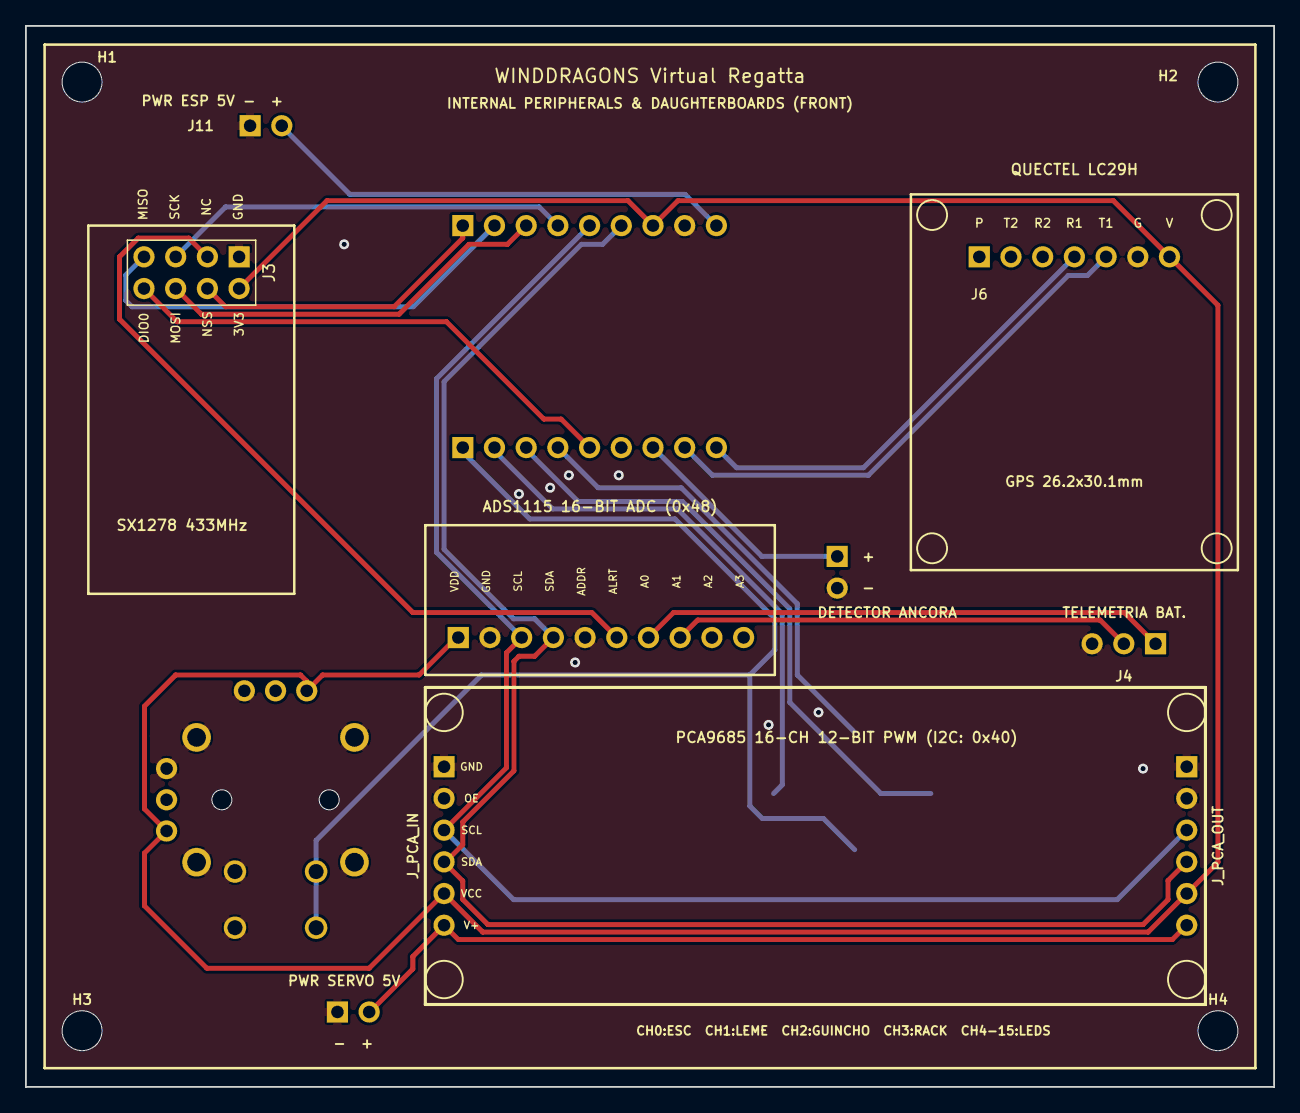
[picture p19: board Universal_Carrier.kicad_pcb from above]

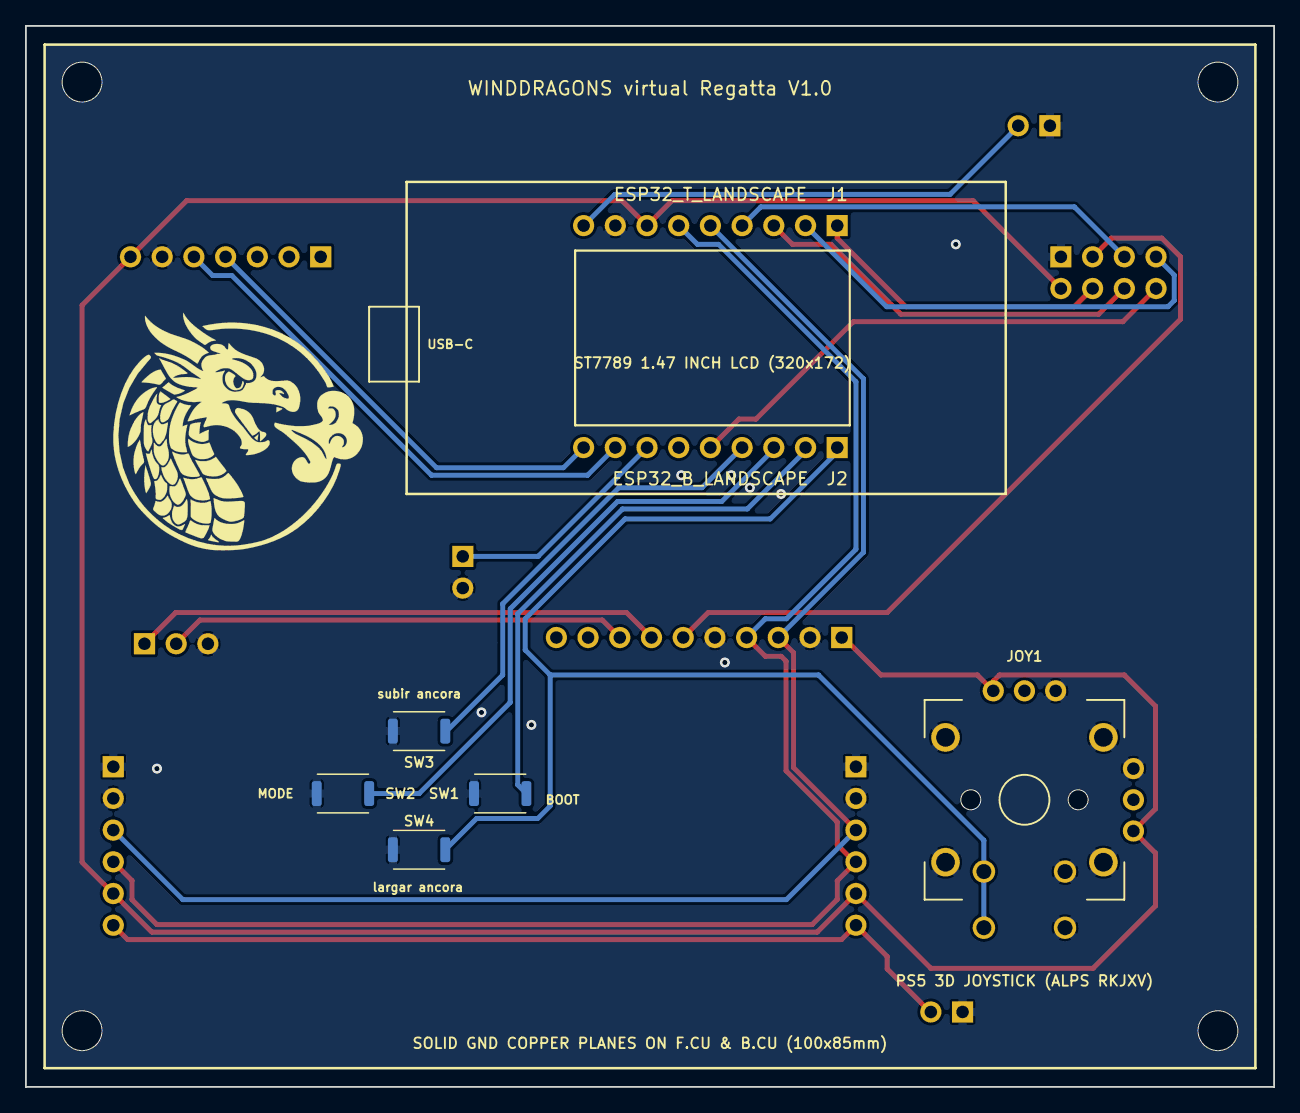
[picture p20: board Universal_Carrier.kicad_pcb from below]

Board: 2 copper layers, 100.0 x 85.0 mm, 21 parts (8 on the bottom side), 21 nets.

Parts:
H1, H2, H3, H4: MountingHole; MountingHole_3.2mm_M3
J1: ESP32_T_LANDSCAPE; PinHeader_1x09_P2.54mm_Horizontal
J2: ESP32_B_LANDSCAPE; PinHeader_1x09_P2.54mm_Horizontal
J3: SX1278_LORA_2x4; PinHeader_2x04_P2.54mm_Vertical
J4: BATT_APM; PinHeader_1x03_P2.54mm_Horizontal
J5: DETECTOR_ANCORA; PinHeader_1x02_P2.54mm_Vertical
J6: GPS_LC29H_7PIN; PinHeader_1x07_P2.54mm_Horizontal
J11: PWR_ESP_5V; PinHeader_1x02_P2.54mm_Horizontal
J12: PWR_SERVO_5V; PinHeader_1x02_P2.54mm_Horizontal
JOY1: PS5_JOYSTICK; Alps_RKJXV1224005
J_ADS: ADS1115_ADC; PinHeader_1x10_P2.54mm_Horizontal
J_PCA_IN: PCA9685_IN; PinHeader_1x06_P2.54mm_Vertical
J_PCA_OUT: PCA9685_OUT; PinHeader_1x06_P2.54mm_Vertical
LOGO1: WindDragons_Logo; WindDragons_Logo_20mm
SW1: subir ancora; SKRKAEE020
SW2: MODE; SKRKAEE020
SW3: largar ancora; SKRKAEE020
SW4: BOOT; SKRKAEE020

Connections:
/+3V3: J1.7, J3.2, J6.7, JOY1.3, JOY1.6, J_ADS.1, J_PCA_IN.5, J_PCA_OUT.5
/+5V: J1.9, J11.2
/+5V_SERVO: J12.2, J_PCA_IN.6, J_PCA_OUT.6
/BATT_CURR_APM: J4.2, J_ADS.8
/BATT_VOLT_APM: J4.1, J_ADS.7
/GND: J1.8, J3.1, J4.3, J5.2, J6.6, J11.1, J12.1, JOY1.1, JOY1.4, JOY1.7, JOY1.8, JOY1.11, JOY1.12, JOY1.13, JOY1.14, J_ADS.2, J_ADS.5, J_PCA_IN.1, J_PCA_IN.2, J_PCA_OUT.1, J_PCA_OUT.2, SW1.2, SW2.2, SW3.2, SW4.2
/I2C_SCL: J1.5, J_ADS.3, J_PCA_IN.3, J_PCA_OUT.3
/I2C_SDA: J1.6, J_ADS.4, J_PCA_IN.4, J_PCA_OUT.4
/IO2_SCK: J1.4, J3.5
/IO3_MOSI: J1.3, J3.6
/IO4_MISO: J1.2, J3.7
/IO5_NSS: J1.1, J3.4
/IO9_BOOT: J2.1, JOY1.9, JOY1.10, SW4.1
/IO13_ANCORA_DET: J2.7, J5.1
/IO16_GPS_RX: J2.8, J6.5
/IO17_GPS_TX: J2.9, J6.4
/IO18_UP: J2.2, SW1.1
/IO19_MODE: J2.3, SW2.1
/IO20_DN: J2.4, SW3.1
/IO23_LORA_DIO0: J2.5, J3.8
/NC: J3.3, J_ADS.6
