tiagojanz/winddragons_rover/src/rover/rover_web_server.h

#pragma once

#include "actuators.h"
#include "battery_monitor.h"
#include "gps_tracker.h"
#include "lora_protocol.h"
#include "qrcode_helper.h"
#include "rover_config_manager.h"
#include "rover_display.h"
#include "rover_version.h"
#include "sd_card_manager.h"
#include "web_console.h"
#include "wifi_config_manager.h"
#include <Arduino.h>
#include <ArduinoJson.h>
#include <Update.h>
#include <WebServer.h>

struct RoverLoraDiagnostics {
  bool hwReady = false;
  uint32_t txTelems = 0;
  uint32_t rxPolls = 0;
  uint32_t lastRxSecAgo = 999999;
  float rssi = 0.0f;
  float snr = 0.0f;
  bool hasContact = false;
};

class RoverWebServer {
public:
  RoverWebServer(WiFiConfigManager &wifiMgr, GPSTracker &gps,
                 BatteryMonitor &battery, ActuatorController &actuators,
                 uint8_t &motorStatus, uint32_t &lastControlTime,
                 RoverConfigManager &configMgr, SDCardManager &sdCard,
                 RoverDisplay *display = nullptr)
      : _server(80), _wifi(wifiMgr), _gps(gps), _battery(battery),
        _actuators(actuators), _motorStatus(motorStatus),
        _lastControlTime(lastControlTime), _config(configMgr),
        _roverId(configMgr.getRoverId()), _sd(sdCard), _display(display) {}

  void begin() {
    setupRoutes();
    _server.begin();
    Serial.println("[ROVER HTTP] Servidor Web ativo na porta 80");
  }

  void handleClient() {
    _server.handleClient();
    if (_restartScheduled > 0 && millis() >= _restartScheduled) {
      _restartScheduled = 0;
      delay(300);
      ESP.restart();
    }
  }

  void setC6OtaStatus(const char *status) {
    if (!status)
      return;
    _c6OtaTimestamp = millis();
    Serial.printf("[ROVER HTTP] C6 OTA Estado: %s\n", status);

    if (strncmp(status, "PROGRESS:", 9) == 0) {
      int pct = atoi(status + 9);
      _c6OtaProgress = pct;
      _c6OtaState = "FLASHING";
      char detail[48];
      snprintf(detail, sizeof(detail), "A gravar Flash C6 (%d%%)...", pct);
      _c6OtaDetail = String(detail);
      if (_display) {
        _display->showOtaScreen("COPROCESSADOR C6", "PASSO 1/2: A GRAVAR FLASH",
                                pct, detail, UI_BLUE);
      }
    } else if (strcmp(status, "STARTING") == 0) {
      _c6OtaState = "STARTING";
      _c6OtaProgress = 20;
      _c6OtaDetail = "C6 a inicializar modo OTA...";
      if (_display) {
        _display->showOtaScreen("COPROCESSADOR C6", "PASSO 1/2: PREPARACAO C6",
                                20, _c6OtaDetail.c_str(), UI_MAGENTA);
      }
    } else if (strcmp(status, "WIFI_CONNECTING") == 0) {
      _c6OtaState = "WIFI_CONNECTING";
      _c6OtaProgress = 25;
      _c6OtaDetail = "C6 a ligar ao WiFi...";
      if (_display) {
        _display->showOtaScreen("COPROCESSADOR C6", "PASSO 1/2: LIGAR AO WIFI",
                                25, _c6OtaDetail.c_str(), UI_ORANGE);
      }
    } else if (strcmp(status, "DOWNLOADING") == 0 ||
               strcmp(status, "FLASH_START") == 0) {
      _c6OtaState = "DOWNLOADING";
      _c6OtaProgress = 30;
      _c6OtaDetail = "C6 a descarregar e a gravar Flash...";
      if (_display) {
        _display->showOtaScreen("COPROCESSADOR C6", "PASSO 1/2: A DESCARREGAR",
                                30, _c6OtaDetail.c_str(), UI_CYAN);
      }
    } else if (strcmp(status, "SUCCESS") == 0) {
      _c6OtaState = "SUCCESS";
      _c6OtaProgress = 100;
      _c6OtaDetail = "Coprocessador C6 atualizado com 100% de sucesso!";
      if (_display) {
        _display->showOtaScreen("COPROCESSADOR C6", "PASSO 1/2: SUCESSO!", 100,
                                "C6 OK! A aguardar Master Lafvin...", UI_GREEN);
      }
    } else if (strncmp(status, "FAIL", 4) == 0) {
      _c6OtaState = String(status);
      _c6OtaDetail = "Falha na gravacao do Coprocessador C6";
      if (_display) {
        _display->showOtaScreen("COPROCESSADOR C6", "PASSO 1/2: FALHA NO C6", 0,
                                status, UI_RED);
      }
    } else {
      _c6OtaState = String(status);
      if (_display) {
        _display->showOtaScreen("COPROCESSADOR C6", "PASSO 1/2: ESTADO",
                                _c6OtaProgress, status, UI_CYAN);
      }
    }
  }

  void setC6Version(const char *ver) {
    if (ver && strlen(ver) > 0) {
      _c6Version = String(ver);
    }
  }

  String getC6Version() const { return _c6Version; }

  void setRoverId(uint8_t id) { _roverId = id; }

  typedef std::function<void(const char *)> CommandQueueCallback;
  void setCommandQueueCallback(CommandQueueCallback cb) {
    _commandQueueCb = cb;
  }

  void setDisplay(RoverDisplay *display) { _display = display; }

  void setLoraDiagnosticsPtr(const RoverLoraDiagnostics *diag) {
    _loraDiag = diag;
  }

  bool isBusy() const { return _isBusy; }

private:
  WebServer _server;
  CommandQueueCallback _commandQueueCb = nullptr;
  const RoverLoraDiagnostics *_loraDiag = nullptr;
  WiFiConfigManager &_wifi;
  GPSTracker &_gps;
  BatteryMonitor &_battery;
  ActuatorController &_actuators;
  uint8_t &_motorStatus;
  uint32_t &_lastControlTime;
  RoverConfigManager &_config;
  uint8_t _roverId;
  SDCardManager &_sd;
  RoverDisplay *_display;
  File _uploadFile;
  bool _isBusy = false;
  bool _uploadSuccess = false;
  String _uploadCurrentPath = "";
  String _c6OtaState = "IDLE";
  String _c6OtaDetail = "";
  uint8_t _c6OtaProgress = 0;
  size_t _lafvinOtaBytes = 0;
  String _c6Version = "--";
  uint32_t _c6OtaTimestamp = 0;
  uint32_t _restartScheduled = 0;

  bool handleStaticFile(String path = "") {
    if (path.isEmpty()) {
      path = _server.uri();
    }
    path = WebServer::urlDecode(path);
    int qIdx = path.indexOf('?');
    if (qIdx != -1) {
      path = path.substring(0, qIdx);
    }
    if (!path.startsWith("/"))
      path = "/" + path;

    if (!_sd.isReady() || !_sd.fileExists(path.c_str())) {
      return false;
    }

    _isBusy = true;
    _sd.prepareBus();
    File f = _sd.openFile(path.c_str(), FILE_READ);
    if (!f || f.isDirectory()) {
      if (f)
        f.close();
      _isBusy = false;
      return false;
    }

    String contentType = "application/octet-stream";
    if (path.endsWith(".html") || path.endsWith(".htm"))
      contentType = "text/html; charset=utf-8";
    else if (path.endsWith(".otf"))
      contentType = "font/otf";
    else if (path.endsWith(".ttf"))
      contentType = "font/ttf";
    else if (path.endsWith(".woff"))
      contentType = "font/woff";
    else if (path.endsWith(".woff2"))
      contentType = "font/woff2";
    else if (path.endsWith(".css"))
      contentType = "text/css; charset=utf-8";
    else if (path.endsWith(".js"))
      contentType = "application/javascript; charset=utf-8";
    else if (path.endsWith(".png"))
      contentType = "image/png";
    else if (path.endsWith(".jpg") || path.endsWith(".jpeg"))
      contentType = "image/jpeg";
    else if (path.endsWith(".svg"))
      contentType = "image/svg+xml";
    else if (path.endsWith(".ico"))
      contentType = "image/x-icon";
    else if (path.endsWith(".json"))
      contentType = "application/json";

    _server.sendHeader("Access-Control-Allow-Origin", "*");
    if (path.endsWith(".otf") || path.endsWith(".ttf") ||
        path.endsWith(".woff") || path.endsWith(".woff2")) {
      _server.sendHeader("Cache-Control",
                         "public, max-age=31536000, immutable");
    } else if (path.endsWith(".html") || path.endsWith(".htm") ||
               path.endsWith(".css") || path.endsWith(".js")) {
      _server.sendHeader("Cache-Control",
                         "no-cache, no-store, must-revalidate");
      _server.sendHeader("Pragma", "no-cache");
      _server.sendHeader("Expires", "0");
    }

    size_t fileSize = f.size();
    _server.setContentLength(fileSize);
    _server.send(200, contentType, "");

    WiFiClient client = _server.client();
    client.setTimeout(5000);
    uint8_t buf[2048];
    while (f.available() && client.connected()) {
      size_t n = f.read(buf, sizeof(buf));
      if (n > 0) {
        client.write(buf, n);
      }
    }
    f.close();
    _isBusy = false;
    return true;
  }

  bool tryServeSdFile(const String &path) {
    if (!_sd.isReady()) {
      return false;
    }
    // Tentar prioritariamente o caminho especializado do Rover: /www/rover/xxx
    if (path.startsWith("/www/") && !path.startsWith("/www/rover/") &&
        !path.startsWith("/www/base/")) {
      String roverPath = "/www/rover/" + path.substring(5);
      if (_sd.fileExists(roverPath.c_str())) {
        return handleStaticFile(roverPath);
      }
    }
    if (!_sd.fileExists(path.c_str())) {
      return false;
    }
    return handleStaticFile(path);
  }

  void setupRoutes() {
    const char *headerKeys[] = {"Content-Length"};
    _server.collectHeaders(headerKeys, 1);

    // Rotas principais (Prioridade ao Cartão SD /www/rover/... com fallback
    // para /www/... e Flash)
    _server.on("/", [this]() {
      if (tryServeSdFile("/www/index.html") || tryServeSdFile("/www/gps.html"))
        return;
      handleGpsPage();
    });

    _server.on("/wifi", [this]() {
      if (tryServeSdFile("/www/wifi.html"))
        return;
      handleWifiPage();
    });
    _server.on("/config", [this]() {
      if (tryServeSdFile("/www/config.html"))
        return;
      handleConfigPage();
    });
    _server.on("/settings", [this]() {
      if (tryServeSdFile("/www/config.html"))
        return;
      handleConfigPage();
    });
    _server.on("/gps", [this]() {
      if (tryServeSdFile("/www/gps.html") || tryServeSdFile("/www/index.html"))
        return;
      handleGpsPage();
    });
    _server.on("/battery", [this]() {
      if (tryServeSdFile("/www/battery.html"))
        return;
      handleBatteryPage();
    });
    _server.on("/control", [this]() {
      if (tryServeSdFile("/www/control.html"))
        return;
      handleControlPage();
    });
    _server.on("/www/control.html", [this]() { handleControlPage(); });
    _server.on("/www/rover/control.html", [this]() { handleControlPage(); });
    _server.on("/sd", [this]() {
      if (tryServeSdFile("/www/sd.html"))
        return;
      handleSdPage();
    });
    _server.on("/favicon.ico",
               [this]() { _server.send(204, "image/x-icon", ""); });

    // APIs JSON & Operações
    _server.on("/api/status", [this]() { handleApiStatus(); });
    _server.on("/api/lora/status", [this]() {
      JsonDocument doc;
      JsonObject lObj = doc.to<JsonObject>();
      lObj["hw_ready"] = _loraDiag ? _loraDiag->hwReady : true;
      lObj["role"] = "rover";
      lObj["freq_mhz"] = LORA_FREQUENCY;
      lObj["bw_khz"] = LORA_BANDWIDTH;
      lObj["sf"] = LORA_SPREAD_FACTOR;
      lObj["cr"] = "4/5";
      lObj["power_dbm"] = LORA_OUTPUT_POWER;
      lObj["tx_telemetry"] = _loraDiag ? _loraDiag->txTelems : 0;
      lObj["rx_polls"] = _loraDiag ? _loraDiag->rxPolls : 0;
      lObj["last_comm_seconds_ago"] =
          _loraDiag ? _loraDiag->lastRxSecAgo : 999999;
      lObj["has_contact"] = _loraDiag ? _loraDiag->hasContact : false;
      lObj["rssi"] = _loraDiag ? _loraDiag->rssi : 0.0f;
      lObj["snr"] = _loraDiag ? _loraDiag->snr : 0.0f;
      String res;
      serializeJson(doc, res);
      _server.send(200, "application/json", res);
    });
    _server.on("/api/lora/send_telem", HTTP_POST, [this]() {
      if (_commandQueueCb) {
        _commandQueueCb("CMD:TX_TELEM");
        _server.send(200, "application/json",
                     "{\"status\":\"ok\",\"message\":\"Telemetria disparada "
                     "via LoRa 433MHz\"}");
      } else {
        _server.send(500, "application/json",
                     "{\"status\":\"error\",\"message\":\"Callback UART "
                     "indisponivel\"}");
      }
    });
    _server.on("/api/scan", [this]() { handleApiScan(); });
    _server.on("/api/wifi/save", [this]() { handleApiWifiSave(); });
    _server.on("/api/wifi/setdefault", [this]() { handleApiWifiSetDefault(); });
    _server.on("/api/wifi/delete", [this]() { handleApiWifiDelete(); });
    _server.on("/api/wifi/connect", [this]() { handleApiWifiConnect(); });
    _server.on("/api/wifi/reconnect", [this]() { handleApiWifiReconnect(); });

    // Configuração geral do Rover (ID, SSID AP, Password AP, Brilho do Ecrã)
    _server.on("/api/rover/config", HTTP_GET,
               [this]() { handleApiRoverConfigGet(); });
    _server.on("/api/rover/config", HTTP_POST,
               [this]() { handleApiRoverConfigSave(); });
    _server.on("/api/rover/config/reload", HTTP_POST,
               [this]() { handleApiRoverConfigReload(); });
    _server.on("/api/display/brightness", HTTP_POST,
               [this]() { handleApiDisplayBrightness(); });

    // Configuração da Bateria (3S, 4S ou 6S e Capacidade mAh)
    _server.on("/api/battery/config", HTTP_GET,
               [this]() { handleApiBatteryConfigGet(); });
    _server.on("/api/battery/config", HTTP_POST,
               [this]() { handleApiBatteryConfigSet(); });
    _server.on("/api/battery/reset", HTTP_POST,
               [this]() { handleApiBatteryReset(); });

    // Configuração do GPS Quectel LC29H (Frequência Hz e Comandos NMEA/PAIR) e
    // Bússola BNO055
    _server.on("/api/gps/rate", HTTP_POST, [this]() { handleApiGpsRate(); });
    _server.on("/api/gps/command", HTTP_POST,
               [this]() { handleApiGpsCommand(); });
    _server.on("/api/compass/calibrate", HTTP_POST, [this]() {
      if (_server.hasArg("plain")) {
        JsonDocument doc;
        if (!deserializeJson(doc, _server.arg("plain"))) {
          if (doc["zero"].as<bool>()) {
            if (_commandQueueCb)
              _commandQueueCb("CMD:COMPASS_ZERO");
            _server.send(200, "application/json",
                         "{\"status\":\"ok\",\"msg\":\"Proa atual definida "
                         "como 0° (Norte)\"}");
            return;
          } else if (doc["offset"].is<float>() || doc["offset"].is<int>()) {
            float off = doc["offset"].as<float>();
            char cmd[48];
            snprintf(cmd, sizeof(cmd), "CMD:COMPASS_OFFSET:%.1f", off);
            if (_commandQueueCb)
              _commandQueueCb(cmd);
            _server.send(
                200, "application/json",
                "{\"status\":\"ok\",\"msg\":\"Offset da bussola atualizado\"}");
            return;
          }
        }
      }
      _server.send(400, "application/json", "{\"status\":\"error\"}");
    });

    // Controle de atuadores
    _server.on("/api/control/actuator", [this]() { handleApiActuator(); });
    _server.on("/api/control/action", [this]() { handleApiAction(); });
    _server.on("/api/control/winch", [this]() { handleApiControlWinch(); });
    _server.on("/api/control/anchor/config",
               [this]() { handleApiAnchorConfig(); });
    _server.on("/api/control/rack/config", [this]() { handleApiRackConfig(); });
    _server.on("/api/control/joystick/config", HTTP_POST,
               [this]() { handleApiJoystickConfig(); });
    _server.on("/api/control/leds", [this]() { handleApiLedControl(); });

    // Gestão do Cartão SD
    _server.on("/api/sd/list", [this]() { handleApiSdList(); });
    _server.on("/api/sd/read", [this]() { handleApiSdRead(); });
    _server.on("/api/sd/download", [this]() { handleApiSdDownload(); });
    _server.on("/api/sd/save", [this]() { handleApiSdSave(); });
    _server.on("/api/sd/delete", [this]() { handleApiSdDelete(); });
    _server.on("/api/sd/delete_dir", [this]() { handleApiSdDeleteDir(); });
    _server.on("/api/sd/mkdir", [this]() { handleApiSdMkdir(); });

    // Upload de ficheiros para o SD
    _server.on(
        "/api/sd/upload", HTTP_POST, [this]() { handleApiSdUploadFinish(); },
        [this]() { handleApiSdUploadData(); });

    // Servir o binario para o C6 descarregar via HTTPUpdate
    _server.on("/firmware/c6.bin", HTTP_GET, [this]() {
      if (_sd.isReady() && _sd.fileExists("/firmware/c6.bin")) {
        File f = _sd.openFile("/firmware/c6.bin", FILE_READ);
        if (f) {
          _server.sendHeader("Access-Control-Allow-Origin", "*");
          _server.client().setTimeout(30000);
          _server.streamFile(f, "application/octet-stream");
          f.close();
          return;
        }
      }
      _server.send(404, "text/plain",
                   "Firmware c6.bin nao encontrado no cartao SD");
    });

    // Endpoints de atualizacao OTA do Rover (Dual-Core C6 + Lafvin)
    _server.on(
        "/api/ota/c6", HTTP_POST, [this]() { handleOtaC6UploadFinish(); },
        [this]() { handleOtaC6UploadData(); });
    _server.on("/api/ota/c6/status", HTTP_GET,
               [this]() { handleApiOtaC6Status(); });
    _server.on(
        "/api/ota/lafvin", HTTP_POST, [this]() { handleApiOtaLafvinFinish(); },
        [this]() { handleApiOtaLafvinData(); });

    // Endpoints de Consola e Monitor de Logs em Tempo Real
    _server.on("/api/console", HTTP_GET, [this]() {
      uint32_t since = 0;
      if (_server.hasArg("since")) {
        since = (uint32_t)_server.arg("since").toInt();
      }
      _server.send(200, "application/json", webConsole.getJsonSince(since));
    });
    _server.on("/api/console/send", HTTP_POST, [this]() {
      String cmd = "";
      if (_server.hasArg("cmd")) {
        cmd = _server.arg("cmd");
      } else if (_server.hasArg("plain")) {
        cmd = _server.arg("plain");
      }
      cmd.trim();
      if (cmd.length() > 0) {
        if (cmd.equalsIgnoreCase("CLEAR")) {
          webConsole.clear();
          _server.send(200, "application/json",
                       "{\"status\":\"ok\",\"action\":\"cleared\"}");
          return;
        }
        if (_commandQueueCb) {
          _commandQueueCb(cmd.c_str());
        }
        webConsole.logf("[CONSOLE TX] %s", cmd.c_str());
        _server.send(200, "application/json", "{\"status\":\"ok\"}");
        return;
      }
      _server.send(400, "application/json",
                   "{\"status\":\"error\",\"msg\":\"Missing cmd\"}");
    });
    _server.on("/api/console/clear", HTTP_POST, [this]() {
      webConsole.clear();
      _server.send(200, "application/json", "{\"status\":\"ok\"}");
    });

    // Servir fontes ou outros ficheiros estáticos diretamente do Cartão SD
    _server.on("/system/fonts/Font%20Awesome%206%20Pro-Solid-900.woff2",
               HTTP_GET, [this]() {
                 if (!handleStaticFile(
                         "/system/fonts/Font Awesome 6 Pro-Solid-900.woff2")) {
                   _server.send(
                       404, "text/plain",
                       "Fonte Font Awesome woff2 nao encontrada no cartao SD");
                 }
               });
    _server.on("/system/fonts/Font Awesome 6 Pro-Solid-900.woff2", HTTP_GET,
               [this]() {
                 if (!handleStaticFile(
                         "/system/fonts/Font Awesome 6 Pro-Solid-900.woff2")) {
                   _server.send(
                       404, "text/plain",
                       "Fonte Font Awesome woff2 nao encontrada no cartao SD");
                 }
               });
    _server.on("/system/fonts/Font%20Awesome%206%20Pro-Solid-900.otf", HTTP_GET,
               [this]() {
                 if (!handleStaticFile(
                         "/system/fonts/Font Awesome 6 Pro-Solid-900.otf")) {
                   _server.send(
                       404, "text/plain",
                       "Fonte Font Awesome otf nao encontrada no cartao SD");
                 }
               });
    _server.on(
        "/system/fonts/Font Awesome 6 Pro-Solid-900.otf", HTTP_GET, [this]() {
          if (!handleStaticFile(
                  "/system/fonts/Font Awesome 6 Pro-Solid-900.otf")) {
            _server.send(404, "text/plain",
                         "Fonte Font Awesome otf nao encontrada no cartao SD");
          }
        });

    _server.onNotFound([this]() {
      if (_server.uri().startsWith("/") && !_server.uri().startsWith("/www/")) {
        if (handleStaticFile("/www/rover" + _server.uri())) {
          return;
        }
        if (handleStaticFile("/www" + _server.uri())) {
          return;
        }
      }
      if (handleStaticFile(_server.uri())) {
        return;
      }
      _server.send(404, "text/plain", "Ficheiro ou pagina nao encontrada");
    });
  }

  // -------------------------------------------------------------
  // CSS & HTML TEMPLATES
  // -------------------------------------------------------------
  String getHtmlHeader(const String &title, const String &activeTab) {
    String html = "<!DOCTYPE html><html lang='pt'><head><meta charset='UTF-8'>";
    html +=
        "<meta name='viewport' content='width=device-width,initial-scale=1'>";
    html += "<title>" + title + " - Rover-" + String(_roverId) + "</title>";
    html += "<style>";
    html += ":root{--bg:#0b1329;--card:#16203c;--card-border:#233258;--primary:"
            "#06b6d4;--primary-hover:#0891b2;--text:#f8fafc;--muted:#94a3b8;--"
            "green:#10b981;--yellow:#f59e0b;--red:#ef4444;}";
    html +=
        "*{box-sizing:border-box;margin:0;padding:0;font-family:-apple-system,"
        "BlinkMacSystemFont,'Segoe UI',Roboto,Helvetica,Arial,sans-serif;}";
    html += "body{background:var(--bg);color:var(--text);padding-bottom:40px;"
            "line-height:1.5;}";
    html += ".navbar{background:linear-gradient(135deg,#0e1a38,#162348);border-"
            "bottom:1px solid var(--card-border);padding:14px "
            "20px;display:flex;align-items:center;justify-content:space-"
            "between;flex-wrap:wrap;gap:10px;}";
    html += ".brand{font-size:1.25rem;font-weight:700;color:var(--text);"
            "display:flex;align-items:center;gap:8px;}";
    html += ".brand span{color:var(--primary);}";
    html += ".badge{padding:4px "
            "10px;border-radius:999px;font-size:0.75rem;font-weight:600;text-"
            "transform:uppercase;}";
    html += ".badge-ap{background:#78350f;color:#fde68a;}";
    html += ".badge-sta{background:#064e3b;color:#a7f3d0;}";
    html += ".nav-links{display:flex;gap:8px;background:rgba(0,0,0,0.25);"
            "padding:4px;border-radius:10px;border:1px solid "
            "var(--card-border);overflow-x:auto;}";
    html +=
        ".nav-item{display:inline-flex;align-items:center;gap:6px;padding:8px "
        "14px;border-radius:8px;color:var(--muted);text-decoration:none;font-"
        "size:0.875rem;font-weight:600;white-space:nowrap;transition:0.2s;}";
    html +=
        ".nav-item:hover{color:var(--text);background:rgba(255,255,255,0.05);}";
    html += ".nav-item.active{background:var(--primary);color:#0f172a;}";
    html += ".container{max-width:960px;margin:24px auto;padding:0 16px;}";
    html += ".card{background:var(--card);border:1px solid "
            "var(--card-border);border-radius:14px;padding:20px;margin-bottom:"
            "20px;box-shadow:0 10px 15px -3px rgba(0,0,0,0.3);}";
    html += ".card-title{font-size:1.1rem;font-weight:700;margin-bottom:14px;"
            "display:flex;align-items:center;justify-content:space-between;"
            "color:var(--text);}";
    html += ".grid-2{display:grid;grid-template-columns:repeat(auto-fit,minmax("
            "280px,1fr));gap:16px;}";
    html += ".grid-4{display:grid;grid-template-columns:repeat(auto-fit,minmax("
            "140px,1fr));gap:12px;}";
    html += ".stat-box{background:rgba(0,0,0,0.2);padding:14px;border-radius:"
            "10px;border:1px solid rgba(255,255,255,0.05);}";
    html += ".stat-label{font-size:0.75rem;color:var(--muted);text-transform:"
            "uppercase;font-weight:600;}";
    html += ".stat-value{font-size:1.35rem;font-weight:700;margin-top:4px;"
            "color:var(--text);}";
    html +=
        ".btn{display:inline-flex;align-items:center;justify-content:center;"
        "padding:10px "
        "18px;border-radius:8px;font-weight:600;font-size:0.875rem;cursor:"
        "pointer;border:none;transition:0.2s;text-decoration:none;gap:6px;}";
    html += ".btn-primary{background:var(--primary);color:#0f172a;}";
    html += ".btn-primary:hover{background:var(--primary-hover);}";
    html += ".btn-danger{background:var(--red);color:#fff;}";
    html += ".btn-secondary{background:#334155;color:#fff;}";
    html += ".btn-secondary:hover{background:#475569;}";
    html += ".btn-group{display:flex;gap:8px;flex-wrap:wrap;}";
    html += "table{width:100%;border-collapse:collapse;margin-top:10px;}";
    html += "th,td{padding:10px 12px;text-align:left;border-bottom:1px solid "
            "var(--card-border);font-size:0.875rem;}";
    html += "th{color:var(--muted);font-weight:600;}";
    html += "input,select,textarea{width:100%;padding:10px "
            "12px;background:#0f172a;border:1px solid "
            "var(--card-border);color:#fff;border-radius:8px;margin-top:6px;"
            "font-size:0.9rem;}";
    html += ".form-group{margin-bottom:14px;}";
    html += ".progress-bg{width:100%;height:16px;background:#0f172a;border-"
            "radius:8px;overflow:hidden;margin-top:8px;}";
    html += ".progress-bar{height:100%;transition:width 0.3s;}";
    html += ".slider{width:100%;-webkit-appearance:none;height:10px;background:"
            "#0f172a;border-radius:5px;outline:none;}";
    html += ".slider::-webkit-slider-thumb{-webkit-appearance:none;width:24px;"
            "height:24px;border-radius:50%;background:var(--primary);cursor:"
            "pointer;}";
    // Font Awesome 6 Pro Solid (carregada do Cartão SD)
    html += "@font-face{font-family:'Font Awesome 6 "
            "Pro';src:url('/system/fonts/"
            "Font%20Awesome%206%20Pro-Solid-900.woff2') "
            "format('woff2'),url('/system/fonts/"
            "Font%20Awesome%206%20Pro-Solid-900.otf') "
            "format('opentype');font-weight:900;font-style:normal;font-display:"
            "block;}";
    html += ".fa,.fas,.fa-solid{font-family:'Font Awesome 6 "
            "Pro'!important;font-weight:900;font-style:normal;font-variant:"
            "normal;line-height:1;text-rendering:auto;display:inline-block;"
            "vertical-align:-0.125em;-webkit-font-smoothing:antialiased;-moz-"
            "osx-font-smoothing:grayscale;}";
    html += ".btn i,.nav-item i,.brand i{pointer-events:none;}";
    html += ".fa-robot:before{content:'\\f544';}";
    html += ".fa-wifi:before{content:'\\f1eb';}";
    html += ".fa-gear:before,.fa-cog:before{content:'\\f013';}";
    html += ".fa-folder:before{content:'\\f07b';}";
    html += ".fa-folder-open:before{content:'\\f07c';}";
    html += ".fa-folder-plus:before{content:'\\f65e';}";
    html +=
        ".fa-location-dot:before,.fa-map-marker-alt:before{content:'\\f3c5';}";
    html += ".fa-battery-full:before{content:'\\f240';}";
    html += ".fa-battery-three-quarters:before{content:'\\f241';}";
    html += ".fa-battery-half:before{content:'\\f242';}";
    html += ".fa-battery-quarter:before{content:'\\f243';}";
    html += ".fa-battery-empty:before{content:'\\f244';}";
    html += ".fa-gamepad:before{content:'\\f11b';}";
    html += ".fa-floppy-disk:before,.fa-save:before{content:'\\f0c7';}";
    html += ".fa-sun:before{content:'\\f185';}";
    html += ".fa-moon:before{content:'\\f186';}";
    html += ".fa-cloud-sun:before{content:'\\f6c4';}";
    html += ".fa-bolt:before{content:'\\f0e7';}";
    html += ".fa-tower-broadcast:before,.fa-broadcast-tower:before{content:'"
            "\\f519';}";
    html += ".fa-eye:before{content:'\\f06e';}";
    html += ".fa-eye-slash:before{content:'\\f070';}";
    html += ".fa-rotate:before,.fa-sync:before{content:'\\f021';}";
    html += ".fa-arrow-right:before{content:'\\f061';}";
    html += ".fa-arrow-left:before{content:'\\f060';}";
    html += ".fa-arrow-up:before{content:'\\f062';}";
    html +=
        ".fa-arrow-turn-up:before,.fa-level-up-alt:before{content:'\\f3bf';}";
    html += ".fa-circle-check:before{content:'\\f058';}";
    html += ".fa-circle-xmark:before{content:'\\f057';}";
    html += ".fa-circle:before{content:'\\f111';}";
    html += ".fa-star:before{content:'\\f005';}";
    html += ".fa-plug:before{content:'\\f1e6';}";
    html += ".fa-network-wired:before{content:'\\f6ff';}";
    html += ".fa-map:before{content:'\\f279';}";
    html += ".fa-compass:before{content:'\\f14e';}";
    html +=
        ".fa-gauge-high:before,.fa-tachometer-alt:before{content:'\\f625';}";
    html += ".fa-anchor:before{content:'\\f13d';}";
    html += ".fa-stop:before{content:'\\f04d';}";
    html += ".fa-hand:before{content:'\\f256';}";
    html += ".fa-lock:before{content:'\\f023';}";
    html += ".fa-lock-open:before{content:'\\f3c1';}";
    html += ".fa-house:before,.fa-home:before{content:'\\f015';}";
    html += ".fa-bell:before{content:'\\f0f3';}";
    html += ".fa-triangle-exclamation:before{content:'\\f071';}";
    html += ".fa-trash-can:before,.fa-trash:before{content:'\\f2ed';}";
    html += ".fa-file:before{content:'\\f15b';}";
    html += ".fa-file-lines:before{content:'\\f15c';}";
    html += ".fa-file-pen:before{content:'\\f31c';}";
    html += ".fa-download:before{content:'\\f019';}";
    html += ".fa-upload:before{content:'\\f093';}";
    html += ".fa-cloud-arrow-up:before{content:'\\f0ee';}";
    html += ".fa-magnifying-glass:before,.fa-search:before{content:'\\f002';}";
    html += ".fa-microchip:before{content:'\\f2db';}";
    html += ".fa-sd-card:before{content:'\\f7c2';}";
    html += ".fa-signal:before{content:'\\f012';}";
    html += ".fa-satellite:before{content:'\\f7bf';}";
    html += ".fa-sliders:before{content:'\\f1de';}";
    html += ".fa-xmark:before{content:'\\f00d';}";
    html += ".fa-plus:before{content:'\\2b';}";
    html += ".fa-font:before{content:'\\f031';}";
    html += ".fa-file-code:before{content:'\\f1c9';}";
    html += ".fa-file-image:before{content:'\\f1c5';}";
    html += ".fa-file-zipper:before{content:'\\f1c6';}";
    html += ".fa-table-cells:before,.fa-th:before{content:'\\f00a';}";
    html += ".fa-list:before{content:'\\f03a';}";
    html += ".fa-copy:before{content:'\\f0c5';}";
    html += ".fa-filter:before{content:'\\f0b0';}";
    html += ".fa-qrcode:before{content:'\\f029';}";
    html += ".fa-camera:before{content:'\\f030';}";
    html += ".fa-lightbulb:before{content:'\\f0eb';}";
    html += ".fa-palette:before{content:'\\f53f';}";
    html += ".fa-power-off:before{content:'\\f011';}";
    html += ".fa-wand-magic-sparkles:before{content:'\\e2ca';}";
    html += "</style></head><body>";

    // Navbar
    html += "<header class='navbar'>";
    html += "<div class='brand'><i class='fa-solid fa-robot'></i> WindDragons "
            "<span>Rover-" +
            String(_roverId) + "</span></div>";
    html += "<div class='nav-links'>";
    if (_wifi.isAPMode()) {
      html += "<a href='/wifi' class='nav-item " +
              String(activeTab == "wifi" ? "active" : "") +
              "'><i class='fa-solid fa-wifi'></i> Configuração WiFi</a>";
      html += "<a href='/config' class='nav-item " +
              String(activeTab == "config" ? "active" : "") +
              "'><i class='fa-solid fa-gear'></i> Configurações</a>";
      html += "<a href='/sd' class='nav-item " +
              String(activeTab == "sd" ? "active" : "") +
              "'><i class='fa-solid fa-folder'></i> Cartão SD</a>";
    } else {
      html += "<a href='/wifi' class='nav-item " +
              String(activeTab == "wifi" ? "active" : "") +
              "'><i class='fa-solid fa-wifi'></i> WiFi</a>";
      html += "<a href='/gps' class='nav-item " +
              String(activeTab == "gps" ? "active" : "") +
              "'><i class='fa-solid fa-location-dot'></i> GPS</a>";
      html +=
          "<a href='/battery' class='nav-item " +
          String(activeTab == "battery" ? "active" : "") +
          "'><i class='fa-solid fa-battery-three-quarters'></i> Bateria</a>";
      html += "<a href='/control' class='nav-item " +
              String(activeTab == "control" ? "active" : "") +
              "'><i class='fa-solid fa-gamepad'></i> Comandos</a>";
      html += "<a href='/config' class='nav-item " +
              String(activeTab == "config" ? "active" : "") +
              "'><i class='fa-solid fa-gear'></i> Configurações</a>";
      html += "<a href='/sd' class='nav-item " +
              String(activeTab == "sd" ? "active" : "") +
              "'><i class='fa-solid fa-folder'></i> Cartão SD</a>";
    }
    html += "</div>";
    html += "<div style='display:flex;align-items:center;gap:8px;'>";
    if (_wifi.isAPMode()) {
      html += "<span class='badge badge-ap'><i class='fa-solid "
              "fa-tower-broadcast'></i> MODO AP: " +
              _wifi.getSSID() + "</span>";
    } else {
      html += "<span class='badge badge-sta'><i class='fa-solid fa-wifi'></i> "
              "WIFI: " +
              _wifi.getIPAddress() + "</span>";
    }
    html += "</div></header><main class='container'>";
    return html;
  }

  String getHtmlFooter() {
    return "</main><footer "
           "style='text-align:center;color:var(--muted);font-size:0.75rem;"
           "margin-top:20px;'>WindDragons Onboard Rover Telemetry &copy; "
           "2026</footer></body></html>";
  }

  // -------------------------------------------------------------
  // PÁGINA 1: CONFIGURAÇÃO DE WIFI
  // -------------------------------------------------------------
  void handleWifiPage() {
    String html = getHtmlHeader("Configuração WiFi", "wifi");
    String mac = getDeviceMacAddress();
    String qrSvg = generateQrCodeSvg(mac.c_str(), 140);

    // Card 1: Estado Atual & Identificação com QR Code
    html += "<div class='card'>";
    html +=
        "<div class='card-title'><span><i class='fa-solid "
        "fa-network-wired'></i> Estado da Ligação & Identificação</span><span "
        "class='badge' style='background:#065f46;color:#6ee7b7;'><i "
        "class='fa-solid fa-qrcode'></i> QR Code MAC</span></div>";
    html += "<div "
            "style='display:flex;align-items:center;gap:20px;flex-wrap:wrap;"
            "margin-bottom:14px;'>";
    html += "<div style='text-align:center;'>";
    html += qrSvg;
    html +=
        "<div style='font-size:0.75rem;color:var(--muted);margin-top:6px;'><i "
        "class='fa-solid fa-camera'></i> Digitalizar MAC</div>";
    html += "</div>";
    html += "<div style='flex:1;min-width:240px;'>";
    html += "<div class='grid-2'>";
    html += "<div class='stat-box'><div class='stat-label'>Endereço MAC "
            "(Hardware)</div><div class='stat-value' "
            "style='color:var(--primary);font-family:monospace;font-size:1."
            "15rem;word-break:break-all;'>" +
            mac + "</div></div>";
    html +=
        "<div class='stat-box'><div class='stat-label'>Dispositivo / "
        "ID</div><div class='stat-value' style='color:var(--yellow);'>ROVER-" +
        String(_roverId < 10 ? "0" : "") + String(_roverId) + "</div></div>";
    html += "<div class='stat-box'><div class='stat-label'>Modo de "
            "Operação</div><div class='stat-value' style='color:" +
            String(_wifi.isAPMode() ? "var(--yellow)" : "var(--green)") + "'>";
    html +=
        _wifi.isAPMode() ? "Ponto de Acesso (AP)" : "Conectado à Rede (STA)";
    html += "</div></div>";
    html += "<div class='stat-box'><div class='stat-label'>Endereço "
            "IP</div><div class='stat-value' style='color:var(--primary);'>" +
            _wifi.getIPAddress() + "</div></div>";
    html +=
        "<div class='stat-box'><div class='stat-label'>SSID Ativo</div><div "
        "class='stat-value' style='word-break:break-all;'>" +
        _wifi.getSSID() + "</div></div>";
    html += "<div class='stat-box'><div class='stat-label'>" +
            String(_wifi.isAPMode() ? "Dispositivos Conectados"
                                    : "Sinal WiFi (RSSI)") +
            "</div>";
    html += "<div class='stat-value'>" +
            String(_wifi.isAPMode() ? String(_wifi.getAPStationCount())
                                    : String(_wifi.getRSSI()) + " dBm") +
            "</div></div>";
    html += "</div></div></div>";

    if (_wifi.isAPMode()) {
      html +=
          "<div "
          "style='margin-top:16px;padding:12px;background:#451a03;border-left:"
          "4px solid var(--yellow);border-radius:6px;font-size:0.875rem;'>";
      html += "<strong>Modo Ponto de Acesso:</strong> Conectado ao AP local da "
              "boia. As redes guardadas são gravadas simultaneamente na NVS e "
              "no Cartão SD (<code>/wifi_networks.json</code>).";
      html += "</div>";
    }
    html += "</div>";

    // Card 2: Lista de Redes Guardadas
    html += "<div class='card'>";
    html += "<div class='card-title'><span><i class='fa-solid fa-wifi'></i> "
            "Redes WiFi Guardadas</span> <span "
            "style='font-size:0.8rem;color:var(--muted);'>NVS + Cartão SD "
            "(/wifi_networks.json)</span></div>";
    const auto &nets = _wifi.getNetworks();
    if (nets.empty()) {
      html += "<p style='color:var(--muted);font-size:0.875rem;'>Nenhuma rede "
              "guardada no momento.</p>";
    } else {
      html += "<table><thead><tr><th>SSID</th><th>Estado</th><th>Ações</th></"
              "tr></thead><tbody>";
      for (const auto &n : nets) {
        bool isCurrent =
            _wifi.isConnected() && _wifi.getSSID().equalsIgnoreCase(n.ssid);
        html += "<tr><td><strong>" + n.ssid + "</strong></td>";
        html += "<td>";
        if (isCurrent) {
          html += "<span class='badge' "
                  "style='background:#059669;color:#fff;margin-right:4px;'><i "
                  "class='fa-solid fa-circle'></i> LIGADA</span> ";
        }
        if (n.is_default) {
          html += "<span class='badge' "
                  "style='background:#065f46;color:#6ee7b7;'><i "
                  "class='fa-solid fa-star'></i> PADRÃO</span>";
        } else if (!isCurrent) {
          html +=
              "<span "
              "style='color:var(--muted);font-size:0.8rem;'>Secundária</span>";
        }
        html += "</td>";
        html += "<td><div class='btn-group'>";
        if (isCurrent) {
          html += "<button disabled class='btn' style='padding:6px "
                  "10px;background:#334155;color:#94a3b8;cursor:default;'><i "
                  "class='fa-solid fa-circle-check'></i> Ativa</button>";
        } else {
          html += "<button onclick='connectNetwork(\"" + n.ssid +
                  "\")' class='btn btn-primary' style='padding:6px "
                  "10px;background:#2563eb;'><i class='fa-solid fa-plug'></i> "
                  "Ligar</button>";
        }
        if (!n.is_default) {
          html += "<button onclick='setDefault(\"" + n.ssid +
                  "\")' class='btn btn-secondary' style='padding:6px 10px;'><i "
                  "class='fa-solid fa-star'></i> Definir Padrão</button>";
        }
        html += "<button onclick='deleteNetwork(\"" + n.ssid +
                "\")' class='btn btn-danger' style='padding:6px 10px;'><i "
                "class='fa-solid fa-trash-can'></i> Eliminar</button>";
        html += "</div></td></tr>";
      }
      html += "</tbody></table>";
    }
    html += "</div>";

    // Card 3: Adicionar Nova Ligação
    html += "<div class='card'>";
    html += "<div class='card-title'><span><i class='fa-solid fa-plus'></i> "
            "Adicionar Nova Ligação WiFi</span></div>";
    html += "<form id='wifiForm' onsubmit='saveWifi(event)'>";
    html += "<div class='form-group'><label class='stat-label'>Nome da Rede "
            "(SSID):</label><input type='text' id='ssid' name='ssid' required "
            "placeholder='ex: WiFi_Porto'></div>";
    html += "<div class='form-group'><label class='stat-label'>Palavra-passe "
            "(Password):</label><input type='password' id='pass' name='pass' "
            "placeholder='Password da rede'></div>";
    html +=
        "<div class='form-group' "
        "style='display:flex;align-items:center;gap:10px;margin-top:10px;'>";
    html += "<input type='checkbox' id='is_default' name='is_default' "
            "style='width:auto;margin:0;'>";
    html += "<label for='is_default' "
            "style='cursor:pointer;font-size:0.875rem;'>Marcar esta rede como "
            "<strong>Padrão (Default)</strong> no arranque</label>";
    html += "</div>";
    html += "<div class='btn-group' style='margin-top:14px;'>";
    html += "<button type='submit' class='btn btn-primary'><i class='fa-solid "
            "fa-floppy-disk'></i> Guardar Ligação (NVS + SD)</button>";
    html += "<button type='button' onclick='scanNetworks()' class='btn "
            "btn-secondary'><i class='fa-solid fa-magnifying-glass'></i> "
            "Procurar Redes Próximas</button>";
    if (_wifi.isAPMode()) {
      html += "<button type='button' onclick='reconnectSTA()' class='btn' "
              "style='background:var(--green);color:#fff;'><i class='fa-solid "
              "fa-rotate'></i> Tentar Ligar e Sair do AP</button>";
    }
    html += "</div></form>";
    html += "<div id='scanResults' style='margin-top:16px;'></div>";
    html += "</div>";

    // Card 4: Configuração Geral do Rover e AP (/config.json)
    html += "<div class='card'>";
    html += "<div class='card-title'><span><i class='fa-solid fa-robot'></i> "
            "Identificação do Rover & Ponto de Acesso (AP)</span> <span "
            "style='font-size:0.8rem;color:var(--muted);'>NVS + Cartão SD "
            "(/config.json)</span></div>";
    html += "<form id='cfgForm' onsubmit='saveRoverCfg(event)'>";
    html += "<div class='form-group'><label class='stat-label'>ID do Rover (1 "
            "- 254):</label><input type='number' id='cfg_id' min='1' max='254' "
            "required value='" +
            String(_config.getRoverId()) + "'></div>";
    html += "<div class='form-group'><label class='stat-label'>Nome da Rede AP "
            "(SSID):</label><input type='text' id='cfg_ssid' required value='" +
            _config.getApSsid() + "'></div>";
    html += "<div class='form-group'><label class='stat-label'>Palavra-passe "
            "do AP (mín. 8 caracteres):</label><input type='password' "
            "id='cfg_pass' minlength='8' required value='" +
            _config.getApPassword() + "'></div>";
    html += "<div class='btn-group' style='margin-top:14px;'>";
    html += "<button type='submit' class='btn btn-primary'><i class='fa-solid "
            "fa-floppy-disk'></i> Guardar Identificação (NVS + SD)</button>";
    html += "<a href='/config' class='btn btn-secondary'><i class='fa-solid "
            "fa-gear'></i> Abrir Página de Configurações Completa (Brilho do "
            "Ecrã) <i class='fa-solid fa-arrow-right'></i></a>";
    html += "</div></form></div>";

    // Script interativo
    html += "<script>";
    html += "function saveRoverCfg(e){e.preventDefault();const "
            "id=parseInt(document.getElementById('cfg_id').value);const "
            "s=document.getElementById('cfg_ssid').value;const "
            "p=document.getElementById('cfg_pass').value;";
    html +=
        "fetch('/api/rover/"
        "config',{method:'POST',headers:{'Content-Type':'application/"
        "json'},body:JSON.stringify({rover_id:id,ap_ssid:s,ap_password:p})})";
    html +=
        ".then(r=>r.json()).then(res=>{alert(res.msg);location.reload();});}";
    html += "function saveWifi(e){e.preventDefault();const "
            "s=document.getElementById('ssid').value;const "
            "p=document.getElementById('pass').value;const "
            "d=document.getElementById('is_default').checked;";
    html += "fetch('/api/wifi/"
            "save',{method:'POST',headers:{'Content-Type':'application/"
            "json'},body:JSON.stringify({ssid:s,password:p,is_default:d})})";
    html +=
        ".then(r=>r.json()).then(res=>{alert(res.msg);location.reload();});}";
    html +=
        "function connectNetwork(s){if(confirm('Ligar à rede WiFi \"'+s+'\" "
        "agora?')){fetch('/api/wifi/"
        "connect',{method:'POST',headers:{'Content-Type':'application/"
        "json'},body:JSON.stringify({ssid:s})}).then(r=>r.json()).then(res=>{"
        "alert(res.msg||('A ligar à rede "
        "'+s+'...'));setTimeout(()=>location.reload(),6000);}).catch(()=>{"
        "alert('Comando enviado. A recarregar em 6 "
        "segundos...');setTimeout(()=>location.reload(),6000);});}}";
    html +=
        "function "
        "setDefault(s){fetch('/api/wifi/"
        "setdefault',{method:'POST',headers:{'Content-Type':'application/"
        "json'},body:JSON.stringify({ssid:s})}).then(()=>location.reload());}";
    html +=
        "function deleteNetwork(s){if(confirm('Eliminar rede "
        "'+s+'?')){fetch('/api/wifi/"
        "delete',{method:'POST',headers:{'Content-Type':'application/"
        "json'},body:JSON.stringify({ssid:s})}).then(()=>location.reload());}}";
    html += "function scanNetworks(){const "
            "d=document.getElementById('scanResults');d.innerHTML='<p "
            "style=\"color:var(--muted);\">A pesquisar redes WiFi "
            "próximas...</p>';";
    html += "fetch('/api/"
            "scan').then(r=>r.json()).then(nets=>{if(!nets.length){d.innerHTML="
            "'<p>Nenhuma rede encontrada.</p>';return;}";
    html += "let t='<table><thead><tr><th>SSID</th><th>Sinal "
            "(RSSI)</th><th>Ação</th></tr></thead><tbody>';";
    html += "nets.forEach(n=>{t+='<tr><td><strong>'+n.ssid+'</strong></"
            "td><td>'+n.rssi+' dBm</td><td><button class=\"btn btn-secondary\" "
            "style=\"padding:4px 8px;\" "
            "onclick=\"document.getElementById(\\'ssid\\').value=\\''+n.ssid+'"
            "\\'\">Selecionar</button></td></tr>';});";
    html += "t+='</tbody></table>';d.innerHTML=t;});}";
    html += "function reconnectSTA(){if(confirm('Tentar conectar às redes "
            "guardadas "
            "agora?')){fetch('/api/wifi/"
            "reconnect',{method:'POST'}).then(r=>r.json()).then(res=>{alert("
            "res.msg);setTimeout(()=>location.reload(),4000);});}}";
    html += "</script>";

    html += getHtmlFooter();
    _server.send(200, "text/html", html);
  }

  // -------------------------------------------------------------
  // PÁGINA: CONFIGURAÇÕES GERAIS (/config.json & NVS)
  // -------------------------------------------------------------
  void handleConfigPage() {
    String html = getHtmlHeader("Configurações", "config");

    // Card 1: Estado do Armazenamento de Configurações
    bool hasSd = _sd.isReady();
    bool hasConfigFile = hasSd && _sd.fileExists("/config.json");

    html += "<div class='card'>";
    html +=
        "<div class='card-title'><span><i class='fa-solid fa-floppy-disk'></i> "
        "Ficheiro de Configurações do Sistema</span><span class='badge' "
        "style='background:" +
        String(hasConfigFile ? "#064e3b;color:#a7f3d0;"
                             : "#78350f;color:#fde68a;") +
        "'>" +
        String(hasConfigFile
                   ? "<i class='fa-solid fa-sd-card'></i> MicroSD: /config.json"
                   : "<i class='fa-solid fa-microchip'></i> Apenas Flash NVS") +
        "</span></div>";
    html += "<p "
            "style='color:var(--muted);font-size:0.875rem;margin-bottom:14px;'>"
            "As opções abaixo são gravadas sincronizadamente no ficheiro "
            "<code>/config.json</code> do Cartão MicroSD e na partição "
            "não-volátil NVS do ESP32.</p>";

    html += "<div class='grid-4'>";
    html += "<div class='stat-box'><div class='stat-label'>ID Ativo</div><div "
            "class='stat-value' style='color:var(--primary);'>Rover-" +
            String(_config.getRoverId()) + "</div></div>";
    html += "<div class='stat-box'><div class='stat-label'>Brilho do "
            "Ecrã</div><div class='stat-value' id='summaryBright' "
            "style='color:var(--yellow);'>" +
            String(_config.getScreenBrightness()) + "%</div></div>";
    html +=
        "<div class='stat-box'><div class='stat-label'>SSID AP Local</div><div "
        "class='stat-value' style='font-size:0.95rem;word-break:break-all;'>" +
        _config.getApSsid() + "</div></div>";
    html +=
        "<div class='stat-box'><div class='stat-label'>Estado do "
        "MicroSD</div><div class='stat-value' style='font-size:0.95rem;color:" +
        String(hasSd ? "var(--green)" : "var(--yellow)") + "'>" +
        (hasSd ? "Cartão Pronto" : "Sem Cartão") + "</div></div>";
    html += "</div></div>";

    // Card: Identificação do Dispositivo & Endereço MAC (com QR Code)
    String cfgMac = getDeviceMacAddress();
    String cfgQrSvg = generateQrCodeSvg(cfgMac.c_str(), 140);

    html += "<div class='card' style='border-left:4px solid var(--primary);'>";
    html += "<div class='card-title'><span><i class='fa-solid fa-qrcode'></i> "
            "Endereço MAC & QR Code</span></div>";
    html += "<div "
            "style='display:flex;align-items:center;gap:24px;flex-wrap:wrap;'>";
    html += "<div style='text-align:center;'>";
    html += cfgQrSvg;
    html += "</div>";
    html += "<div style='flex:1;min-width:240px;'>";
    html += "<div "
            "style='color:var(--primary);font-family:monospace;letter-spacing:"
            "2px;font-size:2.6rem;font-weight:900;word-break:break-all;line-"
            "height:1.2;'>" +
            cfgMac + "</div>";
    html += "</div></div></div>";

    // Formulário Principal
    html += "<form id='configForm' onsubmit='saveAllConfig(event)'>";

    // Card 2: Brilho do Ecrã
    html += "<div class='card'>";
    html += "<div class='card-title'><span><i class='fa-solid fa-sun'></i> "
            "Brilho do Ecrã (Display LCD ST7789)</span><span "
            "id='brightValBadge' class='badge' "
            "style='background:#1e293b;color:var(--primary);font-size:0.9rem;"
            "font-weight:700;'>" +
            String(_config.getScreenBrightness()) + "%</span></div>";
    html += "<p "
            "style='color:var(--muted);font-size:0.875rem;margin-bottom:16px;'>"
            "Ajuste o brilho da retroiluminação por PWM (LEDC GPIO 22). Ao "
            "mover o cursor, o ecrã atualiza em tempo real.</p>";

    html += "<div "
            "style='background:rgba(0,0,0,0.25);padding:18px;border-radius:"
            "12px;border:1px solid var(--card-border);'>";
    html += "<div "
            "style='display:flex;align-items:center;justify-content:space-"
            "between;margin-bottom:10px;'>";
    html += "<span style='font-size:0.85rem;color:var(--muted);'><i "
            "class='fa-solid fa-moon'></i> 5% Mínimo</span>";
    html += "<span id='brightDisplayVal' "
            "style='font-size:1.8rem;font-weight:700;color:var(--primary);'>" +
            String(_config.getScreenBrightness()) + "%</span>";
    html += "<span style='font-size:0.85rem;color:var(--muted);'><i "
            "class='fa-solid fa-sun'></i> 100% Máximo</span>";
    html += "</div>";
    html += "<input type='range' id='cfg_bright' min='5' max='100' step='1' "
            "value='" +
            String(_config.getScreenBrightness()) +
            "' class='slider' oninput='onBrightSlide(this.value)' "
            "onchange='onBrightChange(this.value)'>";

    html +=
        "<div style='display:flex;gap:8px;margin-top:16px;flex-wrap:wrap;'>";
    html += "<button type='button' onclick='setPreset(25)' class='btn "
            "btn-secondary' style='padding:6px 12px;font-size:0.8rem;'><i "
            "class='fa-solid fa-moon'></i> 25% (Poupança)</button>";
    html += "<button type='button' onclick='setPreset(50)' class='btn "
            "btn-secondary' style='padding:6px 12px;font-size:0.8rem;'><i "
            "class='fa-solid fa-cloud-sun'></i> 50% (Normal)</button>";
    html += "<button type='button' onclick='setPreset(75)' class='btn "
            "btn-secondary' style='padding:6px 12px;font-size:0.8rem;'><i "
            "class='fa-solid fa-sun'></i> 75% (Dia)</button>";
    html += "<button type='button' onclick='setPreset(100)' class='btn "
            "btn-secondary' style='padding:6px 12px;font-size:0.8rem;'><i "
            "class='fa-solid fa-bolt'></i> 100% (Sol Máximo)</button>";
    html += "</div>";
    html += "</div></div>";

    // Card 3: Identificação do Rover & Rádio
    html += "<div class='card'>";
    html += "<div class='card-title'><span><i class='fa-solid fa-robot'></i> "
            "Identificação do Rover & Rádio LoRa</span></div>";
    html += "<div class='grid-2'>";
    html += "<div class='form-group'><label class='stat-label'>ID do Rover (1 "
            "- 254):</label>";
    html +=
        "<input type='number' id='cfg_id' min='1' max='254' required value='" +
        String(_config.getRoverId()) +
        "' oninput='updateIdPreview(this.value)'>";
    html +=
        "<small "
        "style='color:var(--muted);font-size:0.75rem;margin-top:4px;display:"
        "block;'>Identificador único em mensagens LoRa SX1278 e telemetria: "
        "<strong id='roverTag' style='color:var(--primary);'>ROVER-" +
        String(_config.getRoverId() < 10 ? "0" : "") +
        String(_config.getRoverId()) + "</strong></small>";
    html += "</div>";
    html += "<div class='form-group'><label class='stat-label'>Tipo de "
            "Equipamento:</label>";
    html +=
        "<input type='text' disabled value='WindDragons Autonomous Surface "
        "Rover / Buoy' "
        "style='background:#0b1120;color:var(--muted);cursor:not-allowed;'>";
    html += "<small "
            "style='color:var(--muted);font-size:0.75rem;margin-top:4px;"
            "display:block;'>Hardware: ESP32-C6 + ST7789 1.47\" + LoRa SX1278 "
            "+ MicroSD</small>";
    html += "</div>";
    html += "</div></div>";

    // Card 4: Ponto de Acesso Local (WiFi AP)
    html += "<div class='card'>";
    html +=
        "<div class='card-title'><span><i class='fa-solid "
        "fa-tower-broadcast'></i> Ponto de Acesso Local (WiFi AP)</span></div>";
    html += "<div class='grid-2'>";
    html += "<div class='form-group'><label class='stat-label'>Nome da Rede AP "
            "(SSID):</label>";
    html += "<input type='text' id='cfg_ssid' required value='" +
            _config.getApSsid() + "'>";
    html +=
        "<small "
        "style='color:var(--muted);font-size:0.75rem;margin-top:4px;display:"
        "block;'>Nome do WiFi emitido quando não conectado a um router</small>";
    html += "</div>";
    html += "<div class='form-group'><label class='stat-label'>Palavra-passe "
            "do AP (mín. 8 caracteres):</label>";
    html += "<div style='display:flex;gap:6px;'>";
    html +=
        "<input type='password' id='cfg_pass' minlength='8' required value='" +
        _config.getApPassword() + "' style='margin-top:0;'>";
    html += "<button type='button' onclick='togglePass()' class='btn "
            "btn-secondary' style='padding:0 12px;font-size:0.85rem;'><i "
            "id='passEye' class='fa-solid fa-eye'></i></button>";
    html += "</div>";
    html +=
        "<small "
        "style='color:var(--muted);font-size:0.75rem;margin-top:4px;display:"
        "block;'>Segurança WPA2-PSK para acesso à telemetria local</small>";
    html += "</div>";
    html += "</div></div>";

    // Card 4.0: Configuração do Joystick Analógico Físico Onboard (GPIO 3 /
    // GPIO 0)
    html += "<div class='card' style='border:1px solid #f59e0b;'>";
    html += "<div class='card-title' "
            "style='display:flex;justify-content:space-between;align-items:"
            "center;flex-wrap:wrap;gap:8px;'>";
    html += "<span><i class='fa-solid fa-gamepad'></i> Joystick Analógico "
            "Físico Onboard (GPIO 3 / GPIO 0)</span>";
    html += "<span id='joyCfgBadge' class='badge' style='background:" +
            String(_config.isJoystickEnabled() ? "#065f46;color:#6ee7b7;"
                                               : "#78350f;color:#fde68a;") +
            "'>" +
            String(_config.isJoystickEnabled() ? "ATIVO (MONTADO)"
                                               : "DESATIVADO (NÃO MONTADO)") +
            "</span>";
    html += "</div>";
    html += "<p "
            "style='color:var(--muted);font-size:0.85rem;margin-bottom:12px;'>"
            "Ative ou desative a leitura do joystick analógico físico na placa "
            "do Rover. <b>Desative esta opção nas situações em que o joystick "
            "não está fisicamente montado</b> para evitar leituras flutuantes "
            "nos pinos ADC (GPIO 3 e GPIO 0) e acionamentos involuntários do "
            "motor ou leme.</p>";
    html += "<div "
            "style='display:flex;flex-wrap:wrap;gap:14px;align-items:center;"
            "justify-content:space-between;'>";
    html += "<div style='display:flex;align-items:center;gap:10px;padding:10px "
            "14px;background:rgba(15,23,42,0.6);border:1px solid "
            "#334155;border-radius:8px;flex:1;min-width:260px;'>";
    html += "<input type='checkbox' id='cfg_joystick_enabled' " +
            String(_config.isJoystickEnabled() ? "checked" : "") +
            " onchange='saveJoystickConfig(this.checked)' "
            "style='width:20px;height:20px;margin:0;cursor:pointer;'>";
    html += "<label for='cfg_joystick_enabled' "
            "style='cursor:pointer;font-size:0.92rem;font-weight:600;'>"
            "Habilitar Joystick Analógico Físico no Rover";
    html += "<div "
            "style='font-size:0.75rem;font-weight:normal;color:var(--muted);"
            "margin-top:2px;'>Desmarque quando o Rover operar sem joystick "
            "físico soldado/ligado na PCB.</div></label>";
    html += "</div></div></div>";

    // Card 4.1: Calibração do Travão da Cremalheira (Sweet Spot de Encosto,
    // Ponto Livre e Direção)
    html += "<div class='card' style='border:1px solid #10b981;'>";
    html += "<div class='card-title' "
            "style='display:flex;justify-content:space-between;align-items:"
            "center;flex-wrap:wrap;gap:8px;'>";
    html += "<span><i class='fa-solid fa-sliders'></i> Calibração do Servo "
            "\"Travão da Cremalheira\" (GPIO 21)</span>";
    html += "<span id='rackDirBadge' class='badge' style='background:" +
            String(_config.isRackInverted() ? "#065f46;color:#6ee7b7;"
                                            : "#1e293b;color:var(--muted);") +
            "'>" +
            String(_config.isRackInverted() ? "DIREÇÃO: INVERTIDA"
                                            : "DIREÇÃO: NORMAL") +
            "</span>";
    html += "</div>";
    html += "<p "
            "style='color:var(--muted);font-size:0.85rem;margin-bottom:12px;'>"
            "Ajuste a direção de atuação do servo, o <b>sweet spot de encosto "
            "da cremalheira</b> (travada) e o <b>ponto onde fica livre</b> "
            "(solta).</p>";
    html += "<div "
            "style='display:flex;flex-wrap:wrap;gap:16px;align-items:flex-end;"
            "margin-bottom:14px;'>";
    html += "<div><label "
            "style='display:block;font-size:0.8rem;color:var(--muted);margin-"
            "bottom:4px;'>Sweet Spot Encosto / Travada (°):</label>";
    html += "<div style='display:flex;gap:6px;'><input type='number' "
            "id='cfg_rack_engaged' min='0' max='180' value='" +
            String(_config.getRackAngleEngaged()) +
            "' style='width:95px;margin:0;'>";
    html +=
        "<button type='button' onclick='testRackPoint(\"engaged\")' class='btn "
        "btn-secondary' style='padding:8px 12px;'>Testar</button></div></div>";
    html += "<div><label "
            "style='display:block;font-size:0.8rem;color:var(--muted);margin-"
            "bottom:4px;'>Ponto Livre / Solta (°):</label>";
    html += "<div style='display:flex;gap:6px;'><input type='number' "
            "id='cfg_rack_released' min='0' max='180' value='" +
            String(_config.getRackAngleReleased()) +
            "' style='width:95px;margin:0;'>";
    html += "<button type='button' onclick='testRackPoint(\"released\")' "
            "class='btn btn-secondary' style='padding:8px "
            "12px;'>Testar</button></div></div>";
    html += "<div style='display:flex;align-items:center;gap:8px;padding:8px "
            "12px;background:rgba(15,23,42,0.6);border:1px solid "
            "#334155;border-radius:8px;'>";
    html += "<input type='checkbox' id='cfg_rack_inverted' " +
            String(_config.isRackInverted() ? "checked" : "") +
            " onchange='saveRackConfig()' "
            "style='width:18px;height:18px;margin:0;cursor:pointer;'>";
    html += "<label for='cfg_rack_inverted' "
            "style='cursor:pointer;font-size:0.88rem;font-weight:600;'>"
            "Inverter Direção do Servo</label></div>";
    html += "<button type='button' onclick='saveRackConfig()' class='btn "
            "btn-primary'><i class='fa-solid fa-floppy-disk'></i> Guardar "
            "Calibração Cremalheira</button>";
    html += "</div>";
    html += "<div style='background:rgba(15,23,42,0.6);border:1px solid "
            "#334155;border-radius:8px;padding:12px;'>";
    html += "<div "
            "style='display:flex;justify-content:space-between;align-items:"
            "center;margin-bottom:6px;'>";
    html += "<span class='stat-label'>Teste / Pesquisa de Sweet Spot Ao Vivo "
            "(0° a 180°):</span>";
    html += "<span id='rackLiveAngleVal' "
            "style='font-weight:700;color:var(--primary);'>" +
            String(_actuators.getCurrentRackAngle()) + "° (" +
            String(_actuators.getCurrentRackPulseUs()) + " µs)</span></div>";
    html += "<input type='range' id='rackTestSlider' min='0' max='180' "
            "step='1' value='" +
            String(_actuators.getCurrentRackAngle()) +
            "' class='slider' oninput='onRackTestSlide(this.value)'>";
    html += "<div class='btn-group' style='margin-top:10px;'>";
    html += "<button type='button' onclick='stepRackTest(-5)' class='btn "
            "btn-secondary'>-5°</button>";
    html += "<button type='button' onclick='stepRackTest(-1)' class='btn "
            "btn-secondary'>-1°</button>";
    html += "<button type='button' onclick='stepRackTest(1)' class='btn "
            "btn-secondary'>+1°</button>";
    html += "<button type='button' onclick='stepRackTest(5)' class='btn "
            "btn-secondary'>+5°</button>";
    html +=
        "<button type='button' onclick='useCurrentAsRack(\"engaged\")' "
        "class='btn btn-secondary' style='background:#065f46;color:#fff;'>Usar "
        "Atual como Encosto</button>";
    html +=
        "<button type='button' onclick='useCurrentAsRack(\"released\")' "
        "class='btn btn-secondary' style='background:#92400e;color:#fff;'>Usar "
        "Atual como Livre</button>";
    html += "<button type='button' onclick='relaxRackServo()' class='btn "
            "btn-secondary' style='background:#475569;color:#fff;'>Relaxar "
            "Servo</button>";
    html += "</div></div></div>";

    // Card 4.2: Calibração do Tambor do Guincho (Sensor Hall DRV5032 - GPIO 20)
    html += "<div class='card' style='border:1px solid #0284c7;'>";
    html += "<div class='card-title'><span><i class='fa-solid "
            "fa-compass-drafting'></i> Calibração do Tambor do Guincho (Sensor "
            "Hall DRV5032 - GPIO 20)</span></div>";
    html +=
        "<div "
        "style='display:flex;flex-wrap:wrap;gap:16px;align-items:flex-end;'>";
    html += "<div><label "
            "style='display:block;font-size:0.8rem;color:var(--muted);margin-"
            "bottom:4px;'>Diâmetro do Tambor (mm):</label>";
    html += "<input type='number' id='cfg_drum_diam' step='0.5' min='5' "
            "max='500' value='" +
            String(_config.getAnchorDrumDiamMm(), 1) +
            "' style='width:130px;margin:0;'></div>";
    html += "<div><label "
            "style='display:block;font-size:0.8rem;color:var(--muted);margin-"
            "bottom:4px;'>Pulsos por Volta (Ímanes):</label>";
    html += "<input type='number' id='cfg_pulses_per_rev' min='1' max='24' "
            "value='" +
            String(_config.getAnchorPulsesPerRev()) +
            "' style='width:110px;margin:0;'></div>";
    html += "<button type='button' onclick='saveAnchorConfig()' class='btn "
            "btn-primary'><i class='fa-solid fa-floppy-disk'></i> Guardar "
            "Calibração do Tambor</button>";
    html += "</div></div>";

    // Card 4.3: Teste e Configuração da Fita de LEDs WS2812B (GPIO 19 - STRB)
    html += "<div class='card' style='border:1px solid #a855f7;'>";
    html += "<div class='card-title' "
            "style='display:flex;justify-content:space-between;align-items:"
            "center;flex-wrap:wrap;gap:8px;'>";
    html += "<span><i class='fa-solid fa-lightbulb' "
            "style='color:#c084fc;'></i> Teste e Configuração da Fita de LEDs "
            "WS2812B (GPIO 19 - Conector STRB)</span>";
    html +=
        "<span id='ledModeBadge' class='badge' "
        "style='background:#3b0764;color:#e9d5ff;border:1px solid #9333ea;'>"
        "MODO: " +
        String(_actuators.getLedMode()) + "</span>";
    html += "</div>";
    html += "<p "
            "style='color:var(--muted);font-size:0.85rem;margin-bottom:14px;'>"
            "Teste interativamente as cores, animações e estroboscópio da fita "
            "de LEDs endereçáveis WS2812B ligada ao pino <b>GPIO 19 (STRB)</b> "
            "do Coprocessador C6.</p>";

    // Linha 1: Modos e Animações de Teste
    html += "<div style='margin-bottom:14px;'>";
    html += "<div class='stat-label' style='margin-bottom:8px;'><i "
            "class='fa-solid fa-wand-magic-sparkles'></i> Modos de Animação e "
            "Sinalização Náutica:</div>";
    html += "<div class='btn-group'>";
    html += "<button type='button' onclick='testLedMode(\"OFF\")' class='btn "
            "btn-danger' style='background:#dc2626;'><i class='fa-solid "
            "fa-power-off'></i> Desligar (OFF)</button>";
    html += "<button type='button' onclick='testLedMode(\"STROBE\")' "
            "class='btn btn-secondary' "
            "style='background:#0284c7;color:#fff;'><i class='fa-solid "
            "fa-bolt'></i> Strobe Náutico (Duplo Flash)</button>";
    html += "<button type='button' onclick='testLedMode(\"NAV\")' class='btn "
            "btn-secondary' "
            "style='background:linear-gradient(90deg,#dc2626,#16a34a);color:#"
            "fff;'>Bombordo / Estibordo (NAV)</button>";
    html += "<button type='button' onclick='testLedMode(\"BEACON\")' "
            "class='btn btn-secondary' "
            "style='background:#d97706;color:#fff;'>Farol Âmbar "
            "(Beacon)</button>";
    html += "<button type='button' onclick='testLedMode(\"RAINBOW\")' "
            "class='btn btn-secondary' "
            "style='background:linear-gradient(90deg,#ef4444,#eab308,#22c55e,#"
            "3b82f6,#a855f7);color:#fff;'>Arco-Íris (Rainbow)</button>";
    html += "<button type='button' onclick='testLedMode(\"CHASE\")' class='btn "
            "btn-secondary' "
            "style='background:#0891b2;color:#fff;'>Scanner Pixel-a-Pixel "
            "(Chase)</button>";
    html += "<button type='button' onclick='testLedMode(\"POLICE\")' "
            "class='btn btn-secondary' "
            "style='background:linear-gradient(90deg,#dc2626,#2563eb);color:#"
            "fff;'>Emergência (Vermelho/Azul)</button>";
    html += "</div></div>";

    // Linha 2: Cores Sólidas Rápidas + Seletor RGB
    html += "<div "
            "style='margin-bottom:14px;background:rgba(15,23,42,0.6);border:"
            "1px solid #334155;border-radius:8px;padding:12px;'>";
    html += "<div class='stat-label' style='margin-bottom:8px;'><i "
            "class='fa-solid fa-palette'></i> Teste de Cores Sólidas (Todos os "
            "LEDs):</div>";
    html += "<div "
            "style='display:flex;flex-wrap:wrap;gap:8px;align-items:center;'>";
    html += "<button type='button' onclick='testLedColor(255,0,0,\"VERMELHO\")'"
            " class='btn' style='background:#ef4444;color:#fff;padding:8px "
            "14px;'>Vermelho</button>";
    html += "<button type='button' onclick='testLedColor(0,255,0,\"VERDE\")' "
            "class='btn' style='background:#22c55e;color:#0f172a;padding:8px "
            "14px;'>Verde</button>";
    html += "<button type='button' onclick='testLedColor(0,0,255,\"AZUL\")' "
            "class='btn' style='background:#3b82f6;color:#fff;padding:8px "
            "14px;'>Azul</button>";
    html += "<button type='button' "
            "onclick='testLedColor(255,255,255,\"BRANCO\")' class='btn' "
            "style='background:#f8fafc;color:#0f172a;padding:8px 14px;'>Branco "
            "Puro</button>";
    html += "<button type='button' "
            "onclick='testLedColor(255,160,0,\"ÂMBAR\")' class='btn' "
            "style='background:#f59e0b;color:#0f172a;padding:8px "
            "14px;'>Âmbar</button>";
    html += "<button type='button' onclick='testLedColor(0,255,255,\"CIANO\")' "
            "class='btn' style='background:#06b6d4;color:#0f172a;padding:8px "
            "14px;'>Ciano</button>";
    html += "<button type='button' "
            "onclick='testLedColor(255,0,255,\"MAGENTA\")' class='btn' "
            "style='background:#d946ef;color:#fff;padding:8px "
            "14px;'>Magenta</button>";
    html += "<div "
            "style='display:flex;align-items:center;gap:6px;margin-left:auto;'>"
            "<label style='font-size:0.8rem;color:var(--muted);'>Cor "
            "Personalizada:</label>";
    html += "<input type='color' id='ledCustomColor' value='#00e5ff' "
            "onchange='testLedHex(this.value)' "
            "style='width:46px;height:36px;padding:2px;margin:0;cursor:pointer;"
            "background:#0f172a;border:1px solid #475569;border-radius:6px;'>";
    html += "</div></div></div>";

    // Linha 3: Brilho e Número de LEDs da Fita
    html += "<div "
            "style='display:flex;flex-wrap:wrap;gap:16px;align-items:flex-end;"
            "background:rgba(15,23,42,0.6);border:1px solid "
            "#334155;border-radius:8px;padding:12px;'>";
    html += "<div style='flex:1;min-width:220px;'>";
    html += "<div "
            "style='display:flex;justify-content:space-between;align-items:"
            "center;margin-bottom:6px;'>";
    html += "<span class='stat-label'>Brilho da Fita de LEDs (5% - "
            "100%):</span>";
    html += "<span id='ledBrightVal' "
            "style='font-weight:700;color:#c084fc;font-size:1.05rem;'>" +
            String(_config.getLedBrightness()) + "%</span></div>";
    html += "<input type='range' id='cfg_led_bright' min='5' max='100' "
            "step='1' value='" +
            String(_config.getLedBrightness()) +
            "' class='slider' oninput='onLedBrightSlide(this.value)'>";
    html += "</div>";
    html += "<div><label "
            "style='display:block;font-size:0.8rem;color:var(--muted);margin-"
            "bottom:4px;'>Nº de LEDs na Fita (1 - 120):</label>";
    html +=
        "<input type='number' id='cfg_led_count' min='1' max='120' value='" +
        String(_config.getLedCount()) +
        "' style='width:110px;margin:0;'></div>";
    html += "<button type='button' onclick='saveLedConfig()' class='btn "
            "btn-primary' style='background:#9333ea;color:#fff;'><i "
            "class='fa-solid fa-floppy-disk'></i> Guardar Config LEDs</button>";
    html += "</div></div>";
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
