tiagojanz/winddragons_rover/(commit log)

2026-10-05 feat: add rack release servo, gravity drop, and alarm control to rover actuators and navigation
2026-10-06 feat: add PCB design files, Gerber exports, and display configuration headers
    [Base_Carrier-B_Cu.gbl, Base_Carrier-B_Mask.gbs, Base_Carrier-B_Silkscreen.gbo, Base_Carrier-Edge_Cuts.gko, Base_Carrier-F_Cu.gtl, Base_Carrier-F_Mask.gts, Base_Carrier-F_Silkscreen.gto, Base_Carrier.drl]
2026-10-06 chore: add local history tracking and lock files for universal pcb hardware project
    [Universal_Carrier-B_Cu.gbl, Universal_Carrier-B_Mask.gbs, Universal_Carrier-B_Paste.gbp, Universal_Carrier-B_Silkscreen.gbo, Universal_Carrier-Edge_Cuts.gko, Universal_Carrier-Edge_Cuts.gm1, Universal_Carrier-F_Cu.gtl, Universal_Carrier-F_Mask.gts]
2026-10-06 feat: add new universal PCB gerbers, logos, and updated design files
    [Universal_Carrier-B_Courtyard.gbr, Universal_Carrier-B_Cu.gbl, Universal_Carrier-B_Fab.gbr, Universal_Carrier-B_Mask.gbs, Universal_Carrier-B_Paste.gbp, Universal_Carrier-B_Silkscreen.gbo, Universal_Carrier-Edge_Cuts.gm1, Universal_Carrier-F_Courtyard.gbr]
2026-10-07 feat: update PCB gerber files and add logo bitmap header
    [Universal_Carrier-B_Courtyard.gbr, Universal_Carrier-B_Cu.gbl, Universal_Carrier-B_Fab.gbr, Universal_Carrier-B_Mask.gbs, Universal_Carrier-B_Paste.gbp, Universal_Carrier-B_Silkscreen.gbo, Universal_Carrier-Edge_Cuts.gm1, Universal_Carrier-F_Courtyard.gbr]
2026-10-07 feat: add web configuration page and API endpoints for screen brightness control and system settings
    [Universal_Carrier.kicad_pcb]
2026-10-08 feat: add hardware joystick testing page and update universal carrier PCB and gerber files
    [Universal_Carrier-B_Courtyard.gbr, Universal_Carrier-B_Cu.gbl, Universal_Carrier-B_Fab.gbr, Universal_Carrier-B_Mask.gbs, Universal_Carrier-B_Paste.gbp, Universal_Carrier-B_Silkscreen.gbo, Universal_Carrier-Edge_Cuts.gm1, Universal_Carrier-F_Courtyard.gbr]
2026-10-09 update universal carrier PCB layout, gerber files, and rover control interface
    [Universal_Carrier-B_Courtyard.gbr, Universal_Carrier-B_Cu.gbl, Universal_Carrier-B_Fab.gbr, Universal_Carrier-B_Mask.gbs, Universal_Carrier-B_Paste.gbp, Universal_Carrier-B_Silkscreen.gbo, Universal_Carrier-Edge_Cuts.gm1, Universal_Carrier-F_Courtyard.gbr]
2026-10-09 feat: add ESP32-C6-LCD-1.47 hardware models and update Universal Carrier PCB design
    [ESP32-C6-LCD-1.47.dxf, ESP32-C6-LCD-1.47.step, ESP32-C6-LCD-1.47.stp, Universal_Carrier.kicad_pcb, Universal_Carrier.step]
2026-10-12 feat: add universal pcb hardware files and update sd upload script
2026-10-12 feat: update Universal Carrier PCB design and hardware configurations for I2C support
2026-10-12 feat: update Universal Carrier PCB design and gerber files with I2C cleanup
2026-10-14 feat: add hardware files and gerbers for dual ESP carrier board
2026-10-14 feat: update hardware layout and gerber files for dual ESP carrier board
2026-10-14 feat: update dual ESP carrier PCB layout and add power and UART test sources
2026-10-15 feat: enhance battery monitoring web UI with dynamic cell configurations and capacity controls
2026-10-16 feat: add limit switch and strobe LED support to hardware and firmware
2026-10-16 feat: separate 3.3V power domains for Lafvin and DevKitC C6 on carrier board
2026-10-16 feat: update Dual ESP carrier PCB layout, gerbers, and pinout documentation
2026-10-16 feat: add Hall sensor footprint and mounting holes to dual ESP carrier PCB
2026-10-16 update Dual_ESP_Carrier hardware files and pinout documentation for the anchor Hall sensor connector
2026-10-18 feat: add Dual ESP32-C6 Over-The-Air (OTA) firmware update UI and bundling script
2026-10-19 update PCB layout and regenerate manufacturing gerbers and firmware archives
2026-10-19 fix: restore joystick web feedback, zero-latency UART commands, and LCD indicator
2026-10-19 docs: standardize universal Dual ESP32-C6 architecture for Rover and Base Station in permanent memory
2026-10-19 feat(base): implement Universal Dual ESP32-C6 architecture and Dual OTA for Base Station
    - Split Base into Master Lafvin (LCD, MicroSD, Web, Joystick) and C6 Coprocessor (dedicated FSPI LoRa 433MHz)
    - Implement Inter-ESP UART link with telemetria, action commands, manual control, and OTA bridge
    - Add dedicated OTA screen and firmware version getters/setters in base_display
    - Add Dual OTA endpoints (/api/ota/c6, /api/ota/c6/status, /api/ota/lafvin) and version reporting in base_web_server
    - Add drag-and-drop dual firmware upgrade card with ZIP extraction in Base Web UI
    - Configure base_lafvin and base_c6 environments in platformio.ini
    - Create scripts/bundle_base_firmware.py producing dist/ba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
2026-10-26 chore: remove KiCad lock files and update active layer in project settings
2026-10-28 feat: add rack brake servo calibration and drum sensor configuration UI
2026-10-28 refactor: add joystick auto-calibration and axis mapping updates
